mikhalych63/DAW-Pro4/DAW-Pro4/Enlosure/Bottom.png

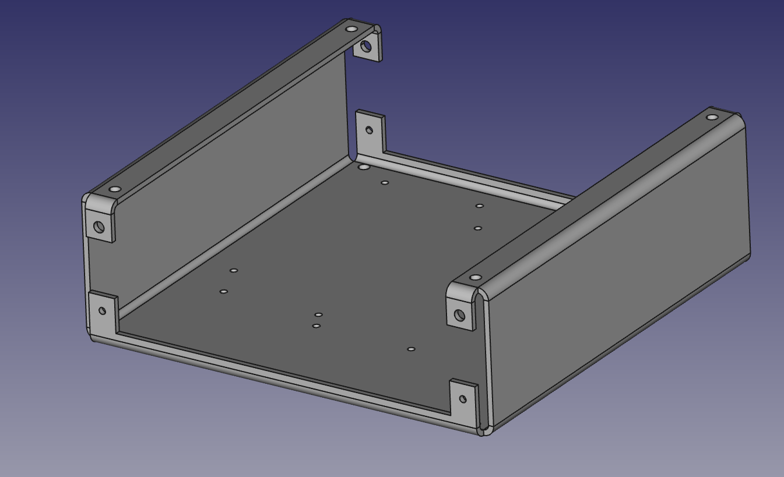
DAW-Pro4/Enlosure/Bottom.png
