mikhalych63/DAW-Pro4/README.md

This is a project of car audio processor and 8ch amplifier wich use of CamillaDSP project: https://github.com/HEnquist/camilladsp
