mikhalych63/DAW-Pro4/DAW-Pro4/Renderers/out/DAW03.pdf

# Digital Audio Ware V3.0

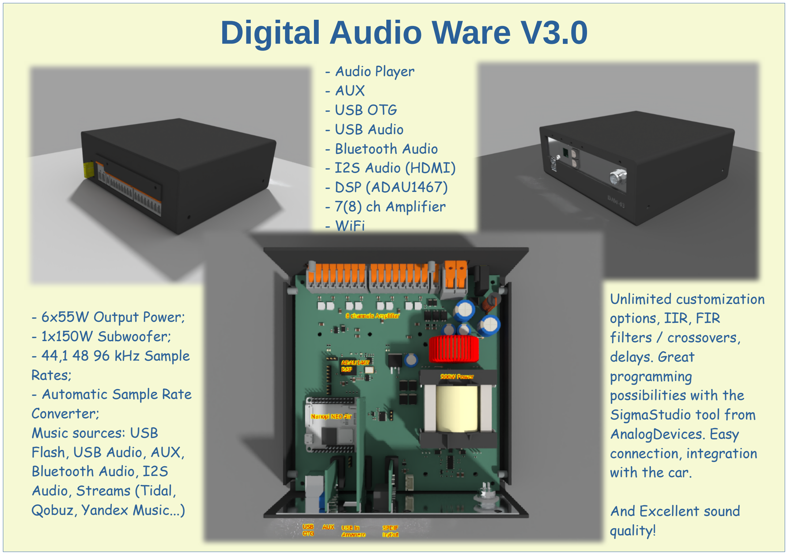
[picture p9: page 1]

- Audio Player
- AUX
- USB OTG
- USB Audio
- Bluetooth Audio
- I2S Audio (HDMI)
- DSP (ADAU1467)
- 7(8) ch Amplifier
- WiFi
- 6x55W Output Power;
- 1x150W Subwoofer;
- 44,1 48 96 kHz Sample
Rates;
- Automatic Sample Rate
Converter;
Music sources: USB
Flash, USB Audio, AUX,
Bluetooth Audio, I2S
Audio, Streams (Tidal,
Qobuz, Yandex Music...)

Unlimited customization
options, IIR, FIR
filters / crossovers,
delays. Great
programming
possibilities with the
SigmaStudio tool from
AnalogDevices. Easy
connection, integration
with the car.

And Excellent sound
quality!
