mikhalych63/DAW-Pro4/DAW-Pro4/Enlosure/enclosure-Bottom.pdf

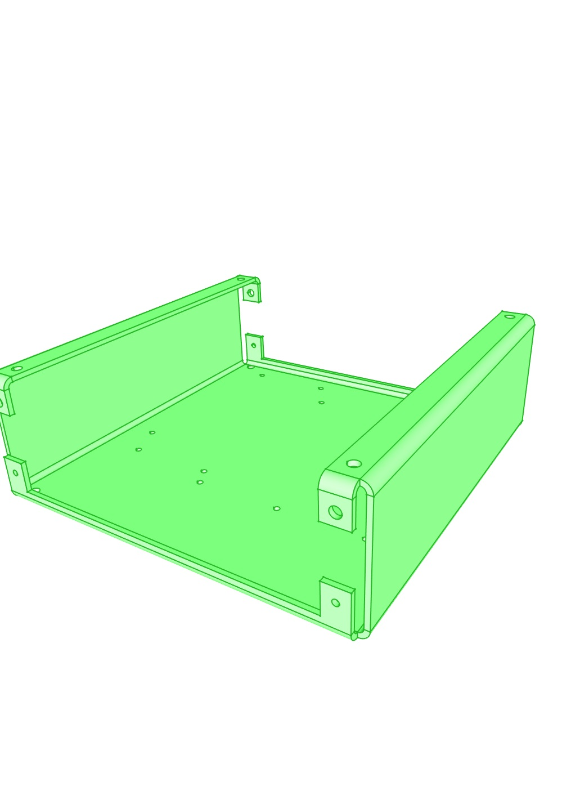
[picture p10: page 1]
