mikhalych63/DAW-Pro4/DAW-Pro4/Enlosure/enclosure-Front.pdf

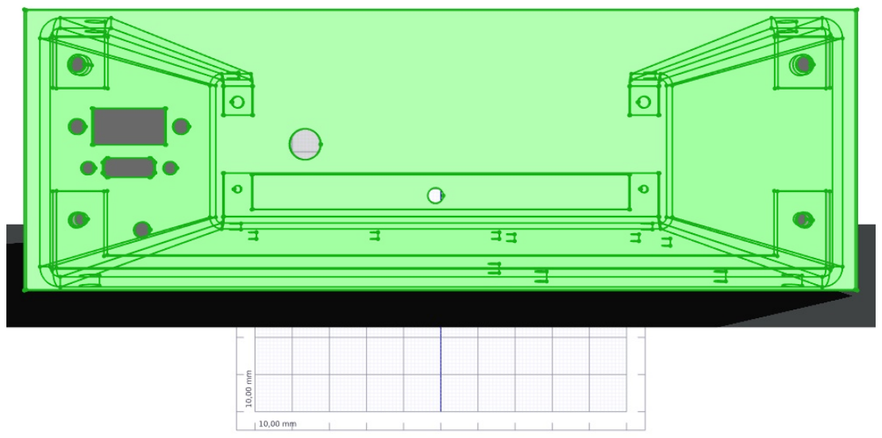
[picture p11: page 1]
