mikhalych63/DAW-Pro4/DAW-Pro4/Enlosure/Лицевая.pdf

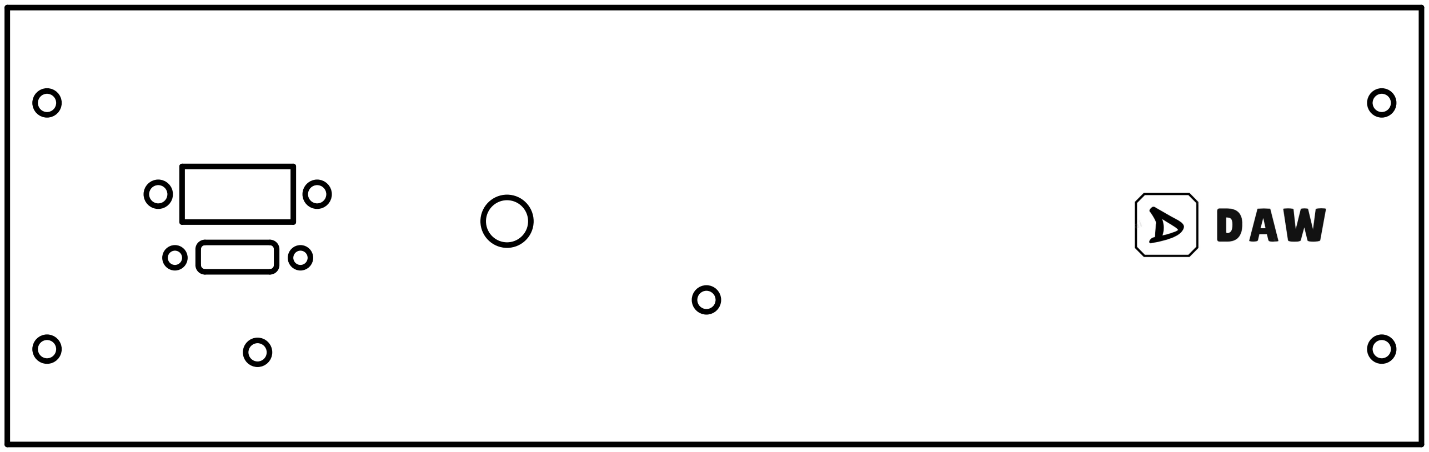
[picture p12: figure]
