mikhalych63/DAW-Pro4/DAW-Pro4/Renderers/0/DAW-Pro4.png

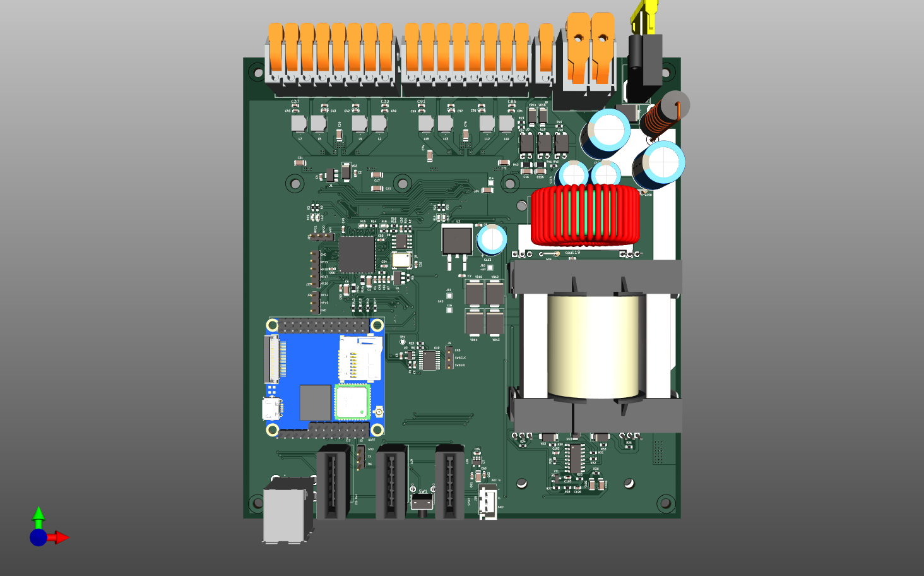
DAW-Pro4/Renderers/0/DAW-Pro4.png
