mikhalych63/DAW-Pro4/DAW-Pro4/Renderers/DAW-Pro4_0.png

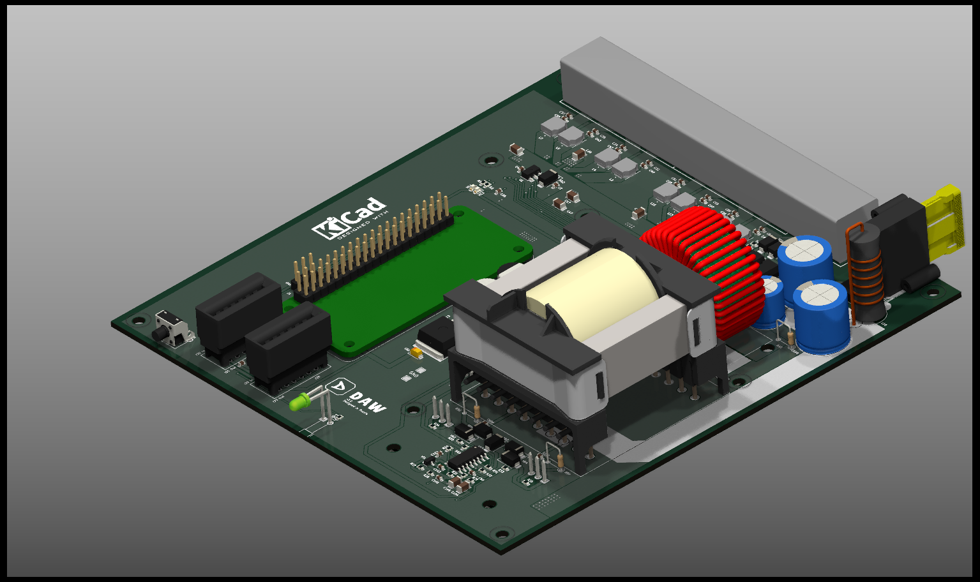
DAW-Pro4/Renderers/DAW-Pro4_0.png
