mikhalych63/DAW-Pro4/DAW-Pro4/Renderers/DAW-Pro4_1.png

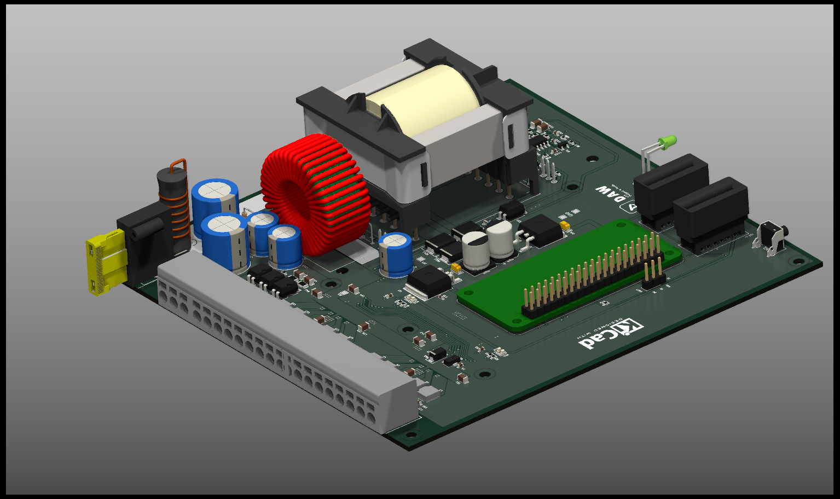
DAW-Pro4/Renderers/DAW-Pro4_1.png
