mikhalych63/DAW-Pro4/DAW-Pro4/Renderers/DAW-Pro4_2.png

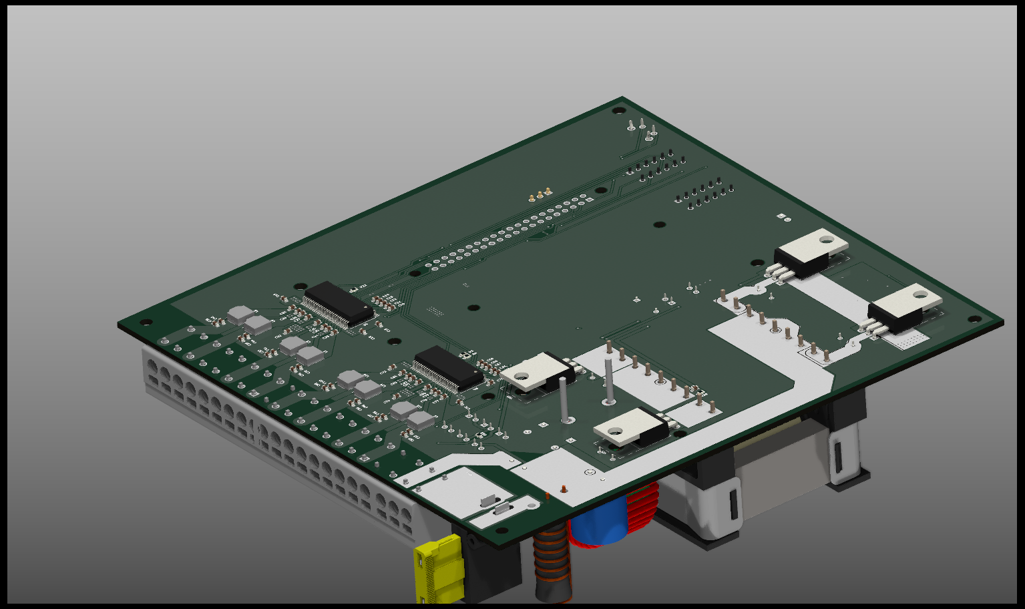
DAW-Pro4/Renderers/DAW-Pro4_2.png
