mikhalych63/DAW-Pro4/DAW-Pro4/Renderers/out/render-back.png

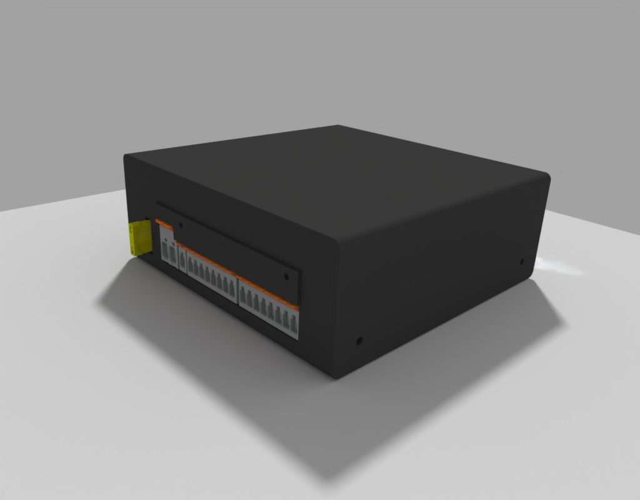
DAW-Pro4/Renderers/out/render-back.png
