mikhalych63/DAW-Pro4/DAW-Pro4/Renderers/out/render-front.png

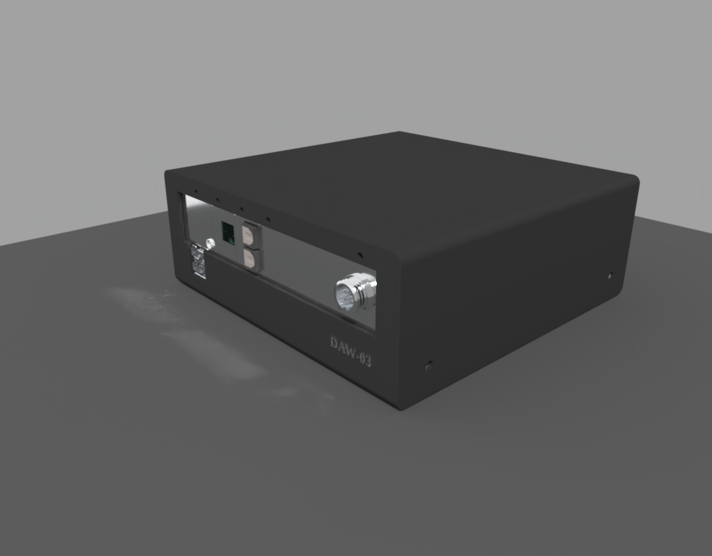
DAW-Pro4/Renderers/out/render-front.png
