mikhalych63/DAW-Pro4/DAW-Pro4/Renderers/out/render-top.png

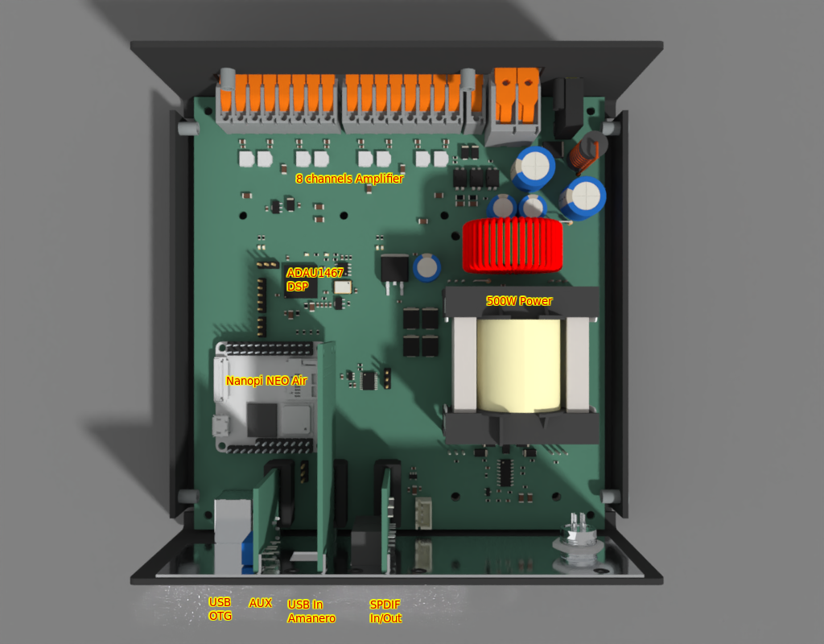
DAW-Pro4/Renderers/out/render-top.png
