mikhalych63/DAW-Pro4/DAW-Pro4/Renderers/render1-alu-cap.png

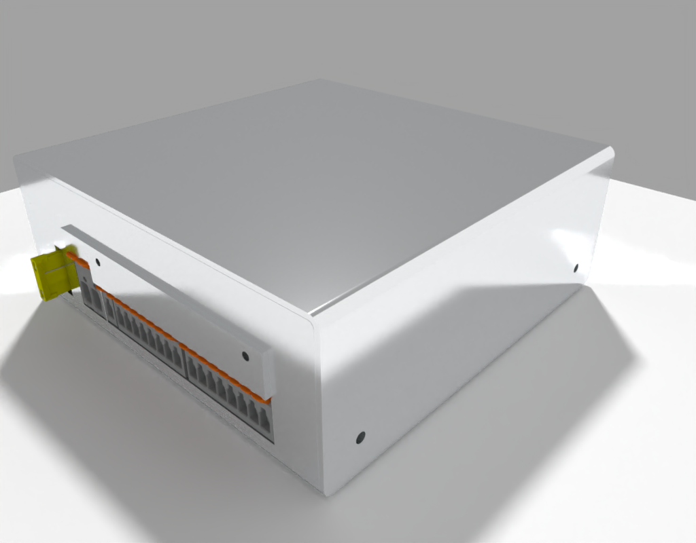
DAW-Pro4/Renderers/render1-alu-cap.png
