mikhalych63/DAW-Pro4/DAW-Pro4/Renderers/render1-black-cap.png

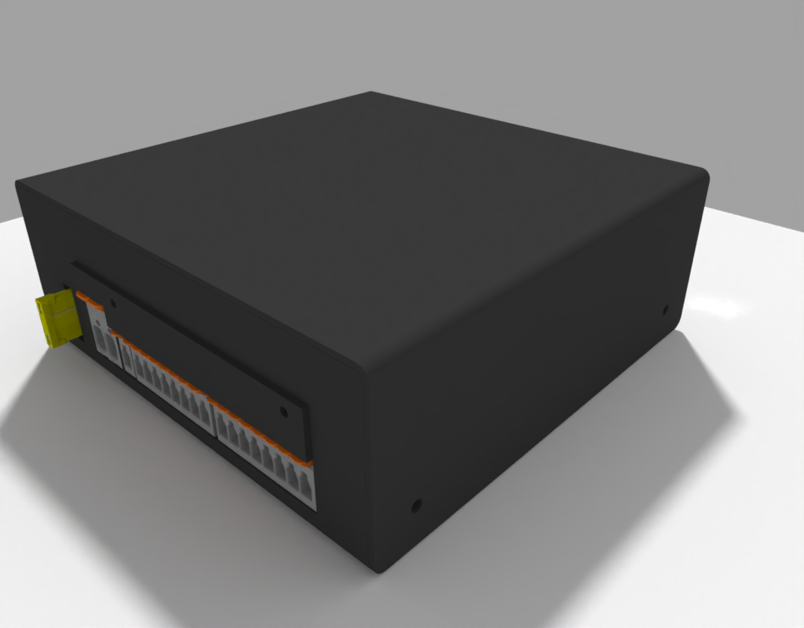
DAW-Pro4/Renderers/render1-black-cap.png
