mikhalych63/DAW-Pro4/DAW-Pro4/Renderers/render1-black.png

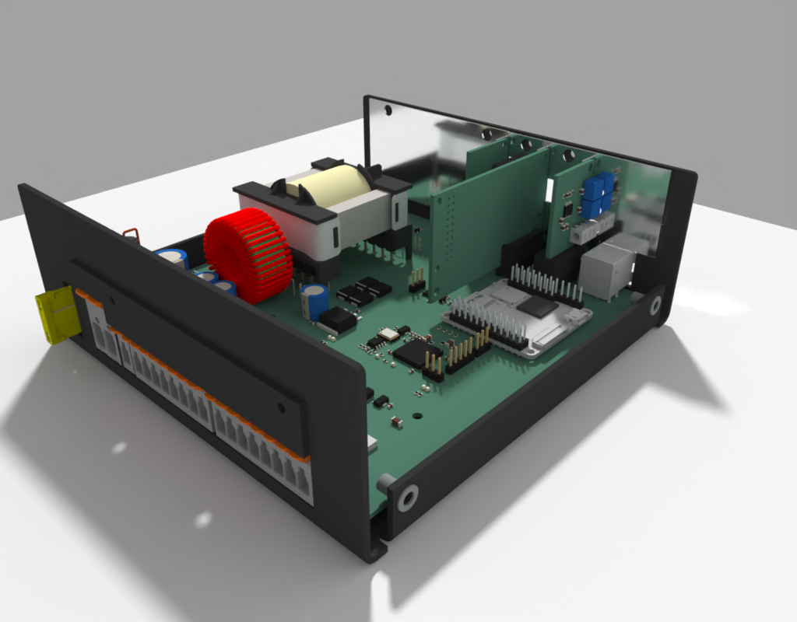
DAW-Pro4/Renderers/render1-black.png
