mikhalych63/DAW-Pro4/DAW-Pro4/Renderers/render2-alu.png

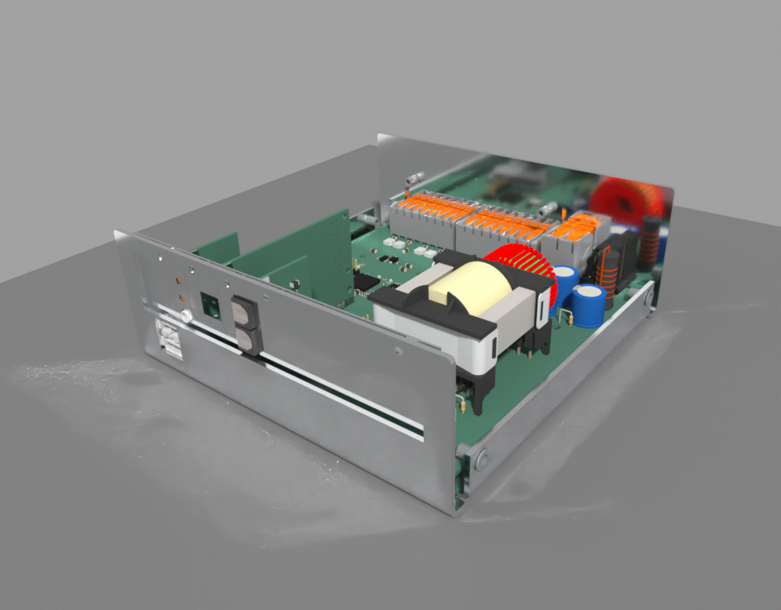
DAW-Pro4/Renderers/render2-alu.png
