mikhalych63/DAW-Pro4/DAW-Pro4/bom/bom_daw00.ods

Идентиф. | Обозначение | Посад.место | Количество | Значение | Поставщик и справка
1 | C104 | C_1206_3216Metric | 1 | CAP_2u2_50V_X7R_1206
2 | C106,C103,C94,C45,C40,C43,C96,C61,C49,C99,C97,C42,C95,C100,C44,C41,C93,C98,C46,C39 | C_0603_1608Metric | 20 | CAP_10n_50V_X7R_0603
3 | C107,C108 | CP_Radial_D14.0mm_P5.00mm | 2 | 2200μ
4 | C11,C68,C25,C81,C80,C65,C29,C66,C27,C26,C83,C69,C78,C84,C67,C77,C82,C10,C14,C79,C12,C24,C28,C23,C13,C30 | C_0603_1608Metric | 26 | CAP_1u0_25V_X7R_0603
5 | C110,C109 | C_0603_1608Metric | 2 | CAP_22n_50V_X7R_0603
6 | C111,C102 | C_0603_1608Metric | 2 | CAP_1n_50V_X7R_0603
7 | C112,C62,C53,C57,C8,C5,C60,C54,C56,C3,C55,C4,C50,C9,C72,C22,C15,C76,C73,C18,C70,C19 | C_0603_1608Metric | 22 | CAP_100n_50V_X7R_0603
8 | C115,C114,C113 | CP_Radial_D10.0mm_P5.00mm | 3 | 330μ
9 | C32,C91,C88,C34,C37,C86,C35,C89,C31,C36,C38,C90,C85,C92,C33,C87 | C_0805_2012Metric | 16 | CAP_1u0_50V_X7R_0805
10 | C48 | C_0603_1608Metric | 1 | CAP_150p_50V_C0G_0603
11 | C51 | C_0603_1608Metric | 1 | CAP_5n6_50V_X7R_0603
12 | C52 | C_0603_1608Metric | 1 | CAP_10n_25V_X7R_0603
13 | C63,C6,C1,C20,C17,C47,C64,C21,C75,C71,C105,C125,C74 | C_1206_3216Metric | 13 | CAP_10u0_50V_X7R_1206
14 | C7,C2 | C_0603_1608Metric | 2 | CAP_0u33_50V_X7R_0603
15 | F1 | Fuse_Blade_vertical | 1 | Fuse
16 | FER1,FER2 | R_0805_2012Metric_Pad1.20x1.40mm_HandSolder | 2 | BLM21AG102SN1D
17 | HL1,HL4 | LED_0603_1608Metric | 2 | LED_SMD_0603_YELLOW
18 | HL3,HL2 | LED_0603_1608Metric | 2 | LED_SMD_0603_RED
19 | HL6,HL5 | LED_0603_1608Metric_Pad1.05x0.95mm_HandSolder | 2 | LED_SMD_0603_BLUE
21 | J12,J20,J19 | Conn_edge_2x6_2.54_Male | 3 | Conn_01x06_Male
26 | J2 | USB_A_STACKED | 1 | USB_A_Stacked
28 | J22 | DEGSON_2x7.5 | 1 | KF206-7.5-2P
31 | J6,J18 | DEGSON_8x5 | 2 | DEGSON 2604 8x5
32 | J8 | DEGSON_1x5 | 1 | DEGSON 2604 1x5
33 | JP1 | R_0603_1608Metric_Pad0.98x0.95mm_HandSolder | 1 | CON_JUMPER
34 | L10,L15,L4,L2,L5,L12,L13,L7,L11,L3,L14,L16,L6,L9,L1,L8 | SPM5010-5020 | 16 | SPM5020T-3R3M-LR_TDK
35 | L18 | L_Axial_L26.0mm_D9.0mm_P5.08mm_Vertical | 1 | 5μ
36 | L19 | L_Axial_L26.0mm_D9.0mm_P5.08mm_Vertical | 1 | 25μ
37 | Q1 | SOT-89-3 | 1 | 2STF2360
38 | R14,R16 | R_0603_1608Metric | 2 | RES_51R0_1%_0.125W_Thick_0603
39 | R20,R3,R2,R21,R8 | R_0603_1608Metric | 5 | RES_1K0_1%_0.125W_Thick_0603
40 | R25 | R_0603_1608Metric | 1 | 15k
41 | R26 | R_0603_1608Metric | 1 | 150
42 | R27 | R_0603_1608Metric | 1 | 3k
43 | R28 | R_0603_1608Metric | 1 | 3,6k
44 | R30,R33,R29 | R_0603_1608Metric | 3 | 10
45 | R35,R34,R32,R31,R39 | R_0603_1608Metric | 5 | 1k
46 | R36,R37 | R_Axial_DIN0204_L3.6mm_D1.6mm_P5.08mm_Vertical | 2 | 4.7
47 | R38 | R_Axial_DIN0204_L3.6mm_D1.6mm_P5.08mm_Vertical | 1 | 100
48 | R4,R5,R22 | R_0603_1608Metric | 3 | RES_4K7_1%_0.125W_Thick_0603
49 | R40 | R_Axial_DIN0204_L3.6mm_D1.6mm_P5.08mm_Vertical | 1 | 1.5k
50 | R41 | R_0603_1608Metric | 1 | 1.2k
51 | R45 | R_0603_1608Metric | 1 | 330
52 | R7 | R_0603_1608Metric | 1 | RES_4K3_1%_0.125W_Thick_0603
53 | R9,R11,R10,R23,R12,R15,R1,R17,R6,R13 | R_0603_1608Metric | 10 | RES_10K0_1%_0.125W_Thick_0603
54 | TP1 | TestPoint_Pad_D1.5mm | 1 | Reset
55 | TR1 | Transformer_ETD44_Horizontal | 1 | TRANSF10
56 | U1 | SOT-89-3 | 1 | L78L18_SOT89
57 | U10 | TSSOP-20_4.4x6.5mm_P0.65mm | 1 | STM32F030F4Px
58 | U12 | Nanopi NEO | 1 | Nanopi NEO Air
59 | U13 | SOIC-16_3.9x9.9mm_P1.27mm | 1 | SG3525
60 | U16,U15 | DIP-4_W7.62mm | 2 | PC817
61 | U2 | TO-263-2 | 1 | LD1086D2T33TR
62 | U3 | SOT-23-5 | 1 | TPS3828-33DBVT
63 | U6 | LFCSP-88-1EP_10x10mm_P0.5mm_EP6.15x6.15mm | 1 | ADAU1467WBCPZ300RL
64 | U7 | SOT-23-5 | 1 | LP2985-5.0
65 | U8,U4 | SSOP-56_7.5x18.5mm_P0.635mm | 2 | TAS6424QDKQRQ1
66 | U9 | SOIC-8_3.9x4.9mm_P1.27mm | 1 | 25AA1024-I/SM
67 | VD1,VD12,VD13,VD11,VD10 | D_SMC | 5 | SS56
68 | VD15,VD4,VD3,VD5,VD14 | D_SMA | 5 | 1N5819
69 | VD2 | D_SMA | 1 | ES1D
70 | VD7,VD6 | D_SMA | 2 | 1N414E
71 | VD9,VD8 | TO-220-3_Horizontal_TabUp | 2 | MBR20100CT
72 | VT1 | SOT-23 | 1 | BC846
73 | VT2,VT3 | TO-220-3_Horizontal_TabUp | 2 | IRF3205
74 | X1 | Oscillator_SMD_SeikoEpson_SG8002CA-4Pin_7.0x5.0mm | 1 | SG-8002CA 24.5760M-PCBL3
