mikhalych63/DAW-Pro4/DAW-Pro4/bom/DAW-Pro4.xlsx

Идентиф. | Обозначение | Посад.место | Значение | Количество | Цена | Сумма | Поставщик и справка
1 | C104 | C_1206_3216Metric | CAP_2u2_50V_X7R_1206 | 1 | 15 | 15
2 | C107,C108 | CP_Radial_D14.0mm_P5.00mm | 2200μ | 2 | 120 | 240
3 | C109,C110 | C_0603_1608Metric | CAP_22n_50V_X7R_0603 | 2 | 2 | 4 | !
4 | C111,C102,C59 | C_0603_1608Metric | CAP_1n_50V_X7R_0603 | 3 | 2 | 6 | !
5 | C115,C114,C113 | CP_Radial_D10.0mm_P5.00mm | CAP_330μ_35V | 3 | 50 | 150
6 | C2 | C_0603_1608Metric | CAP_330n_50V_X7R_0603 | 1 | 2 | 2 | !
7 | C20,C17,C47,C64,C21,C75,C71,C105,C16,C125,C74 | C_1206_3216Metric | CAP_10u0_50V_X7R_1206 | 11 | 20 | 220
8 | C32,C91,C88,C34,C37,C86,C35,C89,C11,C68,C25,C31,C36,C81,C80,C65,C38,C29,C66,C27,C26,C83,C69,C78,C84,C67,C90,C85,C92,C33,C77,C82,C10,C14,C79,C12,C24,C28,C87,C23,C13,C30 | C_0603_1608Metric | CAP_1u_50V_X7R_0603 | 42 | 2 | 84
9 | C57,C54,C56,C55,C4,C72,C22,C15,C112,C76,C73,C18,C70,C19 | C_0603_1608Metric | CAP_100n_50V_X7R_0603 | 14 | 2 | 28 | !
10 | C60,C7 | CP_Elec_8x10 | 10u 16v | 2 | 20 | 40
11 | C8,C61 | CP_EIA-3216-18_Kemet-A | 10u 16v Tantalum | 2 | 25 | 50
12 | C94,C45,C40,C43,C96,C49,C103,C99,C97,C42,C106,C95,C100,C44,C41,C93,C98,C46,C39 | C_0603_1608Metric | CAP_10n_50V_X7R_0603 | 19 | 2 | 38
13 | D1 | D_DO-34_SOD68_P7.62mm_Horizontal | 1N4749A 24V | 1 | 17 | 17
14 | F1 | Fuse_Blade_vertical | Fuse | 1 | 40 | 40 | Ali
15 | HL1,HL4 | LED_0603_1608Metric | LED_SMD_0603_YELLOW | 2 | 18 | 36
16 | HL3,HL2 | LED_0603_1608Metric | LED_SMD_0603_RED | 2 | 18 | 36
17 | IC1 | RockPiS0 | Radxa Rock Pi S0 | 1 | 2500 | 2500 | Ali (заказал 2шт.)
18 | J1 | PinHeader_1x03_P2.54mm_Vertical | UART | 1 |  | 0
19 | J10 | TestPoint_Pad_1.5x1.5mm | +6V | 1 |  | 0
20 | J12,J20 | 2x6 | Conn_edge_2x6_2.54_Male | 2 | 100 | 200 | Ali
21 | J14 | TestPoint_Pad_1.5x1.5mm | +24V | 1 |  | 0
22 | J16,J11 | TestPoint_Pad_1.5x1.5mm | GND | 2 |  | 0
23 | J22 | DG271R-5.0-03P | DG271R-5.0-03P | 1 | 60 | 60
24 | J6,J18 | DG271R-5.0-08P | DG271R-5.0-08P | 2 | 217 | 434
25 | L10,L15,L4,L2,L5,L12,L13,L7,L11,L3,L14,L16,L6,L9,L1,L8 | SPM5020T-3R3M-LR | 3u3 | 16 | 35 | 560
26 | L18 | L_Axial_L26.0mm_D9.0mm_P5.08mm_Vertical | DMR30 5μ | 1 | 35 | 35 | ferrite.ru
27 | L19 | L_Toroid_Vertical_L33.0mm_W17.8mm_P12.70mm_Pulse_KM-5 | DT90-52 25μ | 1 | 25 | 25 | ferrite.ru
28 | R19 | R_0603_1608Metric | 10k | 1 | 2 | 2 | !
29 | R20,R3,R2,R21 | R_0603_1608Metric | 1K | 4 | 2 | 8 | !
30 | R24,R34,R31,R45,R32,R35,R39 | R_0603_1608Metric | 1k | 7 | 2 | 14 | !
31 | R25 | R_0603_1608Metric | 15k | 1 | 2 | 2 | !
32 | R26 | R_0603_1608Metric | 150 | 1 | 2 | 2 | !
33 | R27 | R_0603_1608Metric | 3k | 1 | 2 | 2 | !
34 | R28 | R_0603_1608Metric | 3,6k | 1 | 2 | 2 | !
35 | R33,R30,R29 | R_0603_1608Metric | 10 | 3 | 2 | 6 | !
36 | R36,R37 | R_Axial_DIN0204_L3.6mm_D1.6mm_P5.08mm_Vertical | 4.7 | 2 | 30 | 60
37 | R38 | R_Axial_DIN0204_L3.6mm_D1.6mm_P5.08mm_Vertical | 100 | 1 | 30 | 30
38 | R40 | R_Axial_DIN0204_L3.6mm_D1.6mm_P5.08mm_Vertical | 1.5k | 1 | 30 | 30
39 | R41,R42 | R_1206_3216Metric | 1.2k | 2 | 2 | 4
40 | R43,R18,R4,R5,R22 | R_0603_1608Metric | 4.7K | 5 | 2 | 10 | !
41 | R48 | R_0603_1608Metric | 1.5k | 1 | 2 | 2 | !
42 | R49,R50 | R_0603_1608Metric | 3.3K | 2 | 2 | 4 | !
43 | TR1 | Transformer_ETD44_Horizontal | TRANSF10 | 1 | 400 | 400 | ferrite.ru
44 | U1 | SOT-89-3 | L78L18_SOT89 | 1 | 25 | 25
45 | U11 | DIP-4_W7.62mm | PC817 | 1 | 20 | 20
46 | U13 | SOIC-16_3.9x9.9mm_P1.27mm | SG3525 | 1 | 200 | 200
47 | U16,U15,U5 | DIP-4_W7.62mm | TLP627 | 3 | 70 | 210
48 | U2 | TO-263-2 | LD1086D2T33TR | 1 | 110 | 110
49 | U7 | TO-263-2 | LD1086DT50TR | 1 | 110 | 110
50 | U8,U4 | SSOP-56_7.5x18.5mm_P0.635mm | TAS6424QDKQRQ1 | 2 | 220 | 440 | Ali
51 | VD1,VD12,VD13,VD11,VD10 | D_SMC | SS56 | 5 | 20 | 100
52 | VD15,VD4,VD3,VD5,VD14 | D_SMA | 1N5819 | 5 | 15 | 75
53 | VD2 | D_SMA | ES1D | 1 | 15 | 15
54 | VD7,VD6 | D_SMA | 1N4148 | 2 | 15 | 30
55 | VD9,VD8 | TO-220-3_Horizontal_TabUp | MBR20100CT | 2 | 65 | 130
56 | VT1 | SOT-23 | BC846 | 1 | 15 | 15
57 | VT2,VT3 | TO-220-3_Horizontal_TabUp | IRF3205 | 2 | 55 | 110
 |  |  |  |  |  | 6988
