mikhalych63/DAW-Pro4/DAW-Pro4/amanero/amanero.step

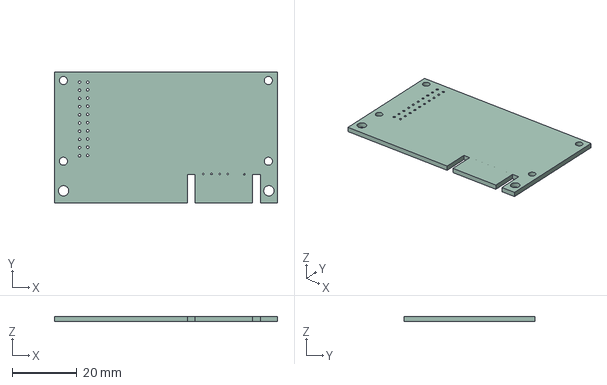
[picture p32: CAD file, 2024-10-08]
DAW-Pro4/amanero/amanero.step
69.1 x 40.6 x 1.60 mm
