mikhalych63/DAW-Pro4/DAW-Pro4/analog_input/analog_input.step

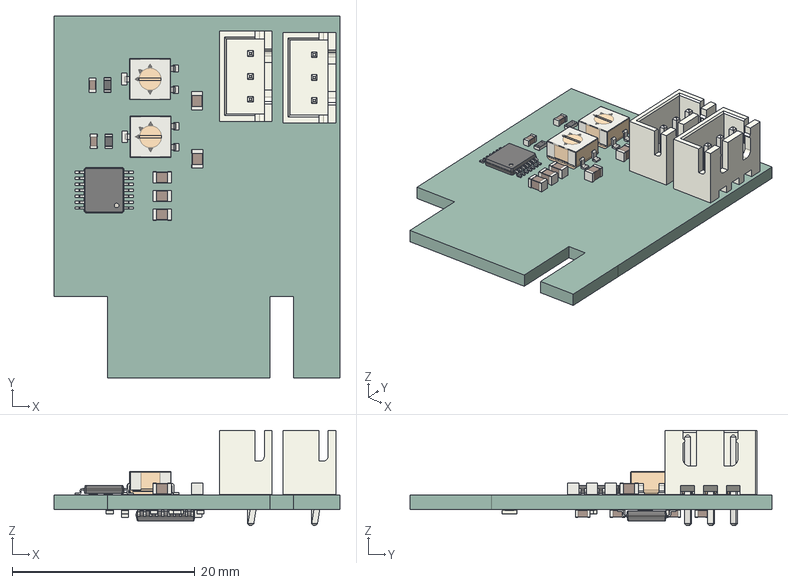
[picture p33: CAD file, 2024-10-08]
DAW-Pro4/analog_input/analog_input.step
31.2 x 39.6 x 10.4 mm
C_0805_2012Metric x 5
R_0603_1608Metric x 9
C_0603_1608Metric x 8
JST_B3B_XH_A x 2
TSSOP_14_44x5mm_P065mm
Potentiometer_Bourns_3314G_Vertical x 2
TSSOP_20_44x65mm_P065mm
analog_input_PCB
