mikhalych63/DAW-Pro4/DAW-Pro4/Enlosure/body.step

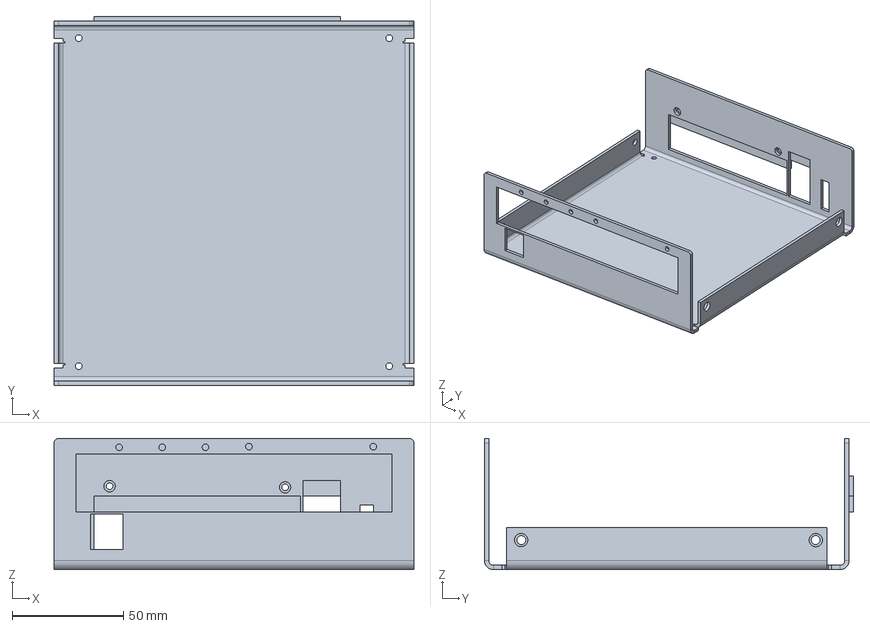
[picture p34: CAD file, 2024-10-08]
DAW-Pro4/Enlosure/body.step
162.0 x 166.1 x 59.0 mm
