mikhalych63/DAW-Pro4/DAW-Pro4/spdif/spdif.step

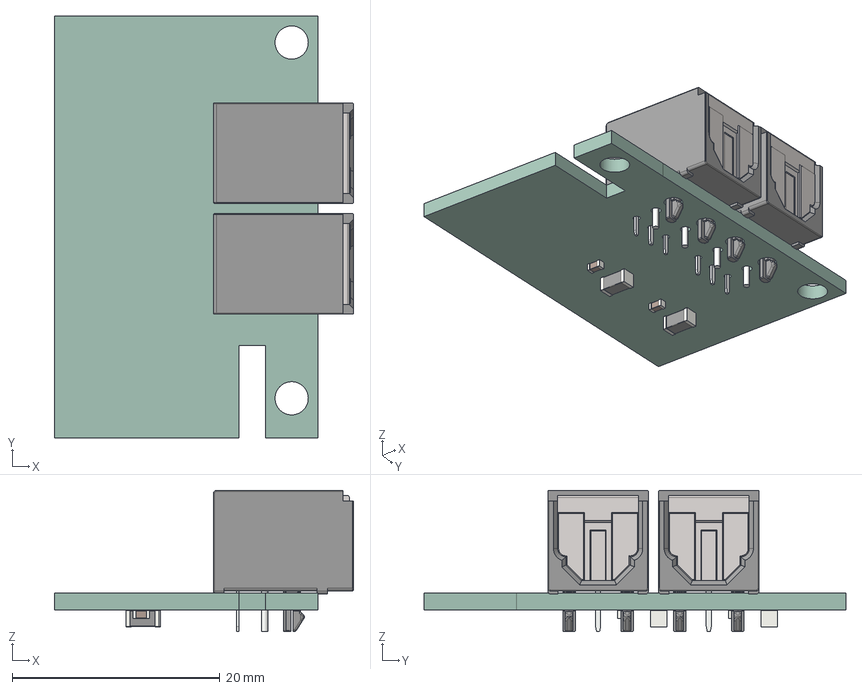
[picture p35: CAD file, 2024-10-08]
DAW-Pro4/spdif/spdif.step
28.8 x 40.6 x 13.6 mm
User Library-TORX147PL(f,t) x 2
L_1206_3216Metric x 2
C_0603_1608Metric x 2
spdif_PCB
