mikhalych63/DAW-Pro4/DAW-Pro4/Enlosure/cap.step

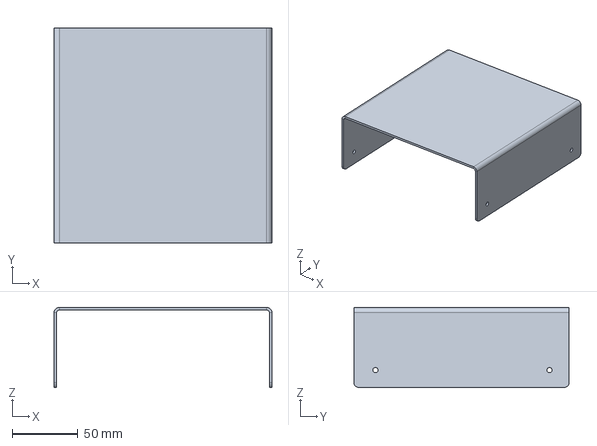
[picture p36: CAD file, 2024-10-08]
DAW-Pro4/Enlosure/cap.step
166.0 x 164.0 x 61.0 mm
