mikhalych63/DAW-Pro4/DAW-Pro4/Enlosure/daw00-analog_input 1.step

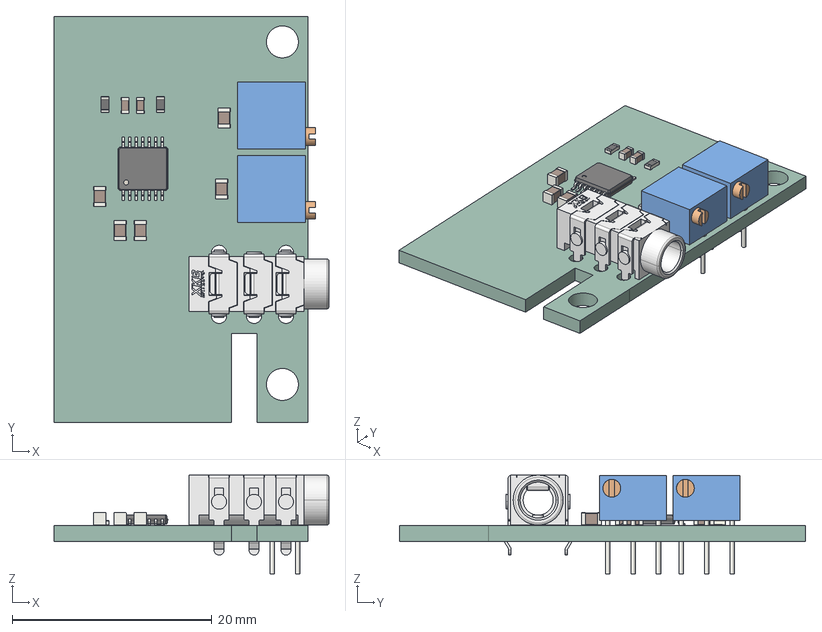
[picture p37: CAD file, 2024-10-08]
DAW-Pro4/Enlosure/daw00-analog_input 1.step
27.5 x 40.6 x 9.88 mm
C_0805_2012Metric032
C_0805_2012Metric034
R_0603_1608Metric078
R_0603_1608Metric080
C_0603_1608Metric154
C_0603_1608Metric156
TSSOP_14_44x5mm_P065mm
Potentiometer_Bourns_3266P_Horizontal
C_0805_2012Metric036
C_0805_2012Metric038
Potentiometer_Bourns_3266P_Horizontal002
C_0805_2012Metric040
PJ-3135-X
analog_input_PCB
