mikhalych63/DAW-Pro4/DAW-Pro4/Enlosure/Лицевая.dxf

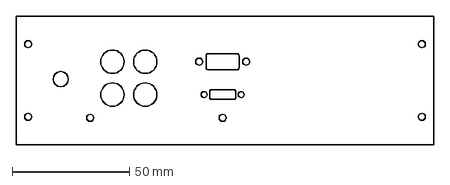
[picture p38: CAD file, 2024-10-08]
DAW-Pro4/Enlosure/Лицевая.dxf
178.0 x 55.0 mm
