mikhalych63/DAW-Pro4/DAW-Pro4/Enlosure/enclosure-Front.step

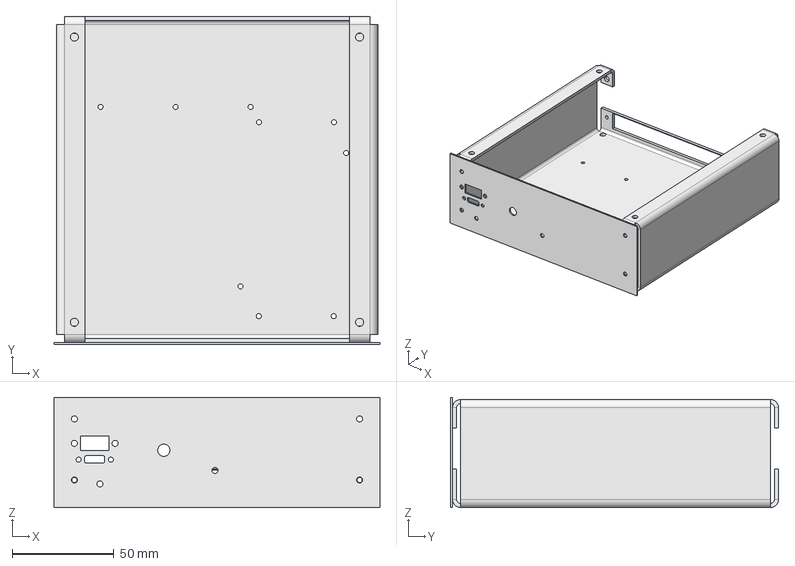
[picture p39: CAD file, 2024-10-08]
DAW-Pro4/Enlosure/enclosure-Front.step
160.0 x 161.0 x 54.0 mm
