mikhalych63/DAW-Pro4/DAW-Pro4/Enlosure/enclosure.FCStd

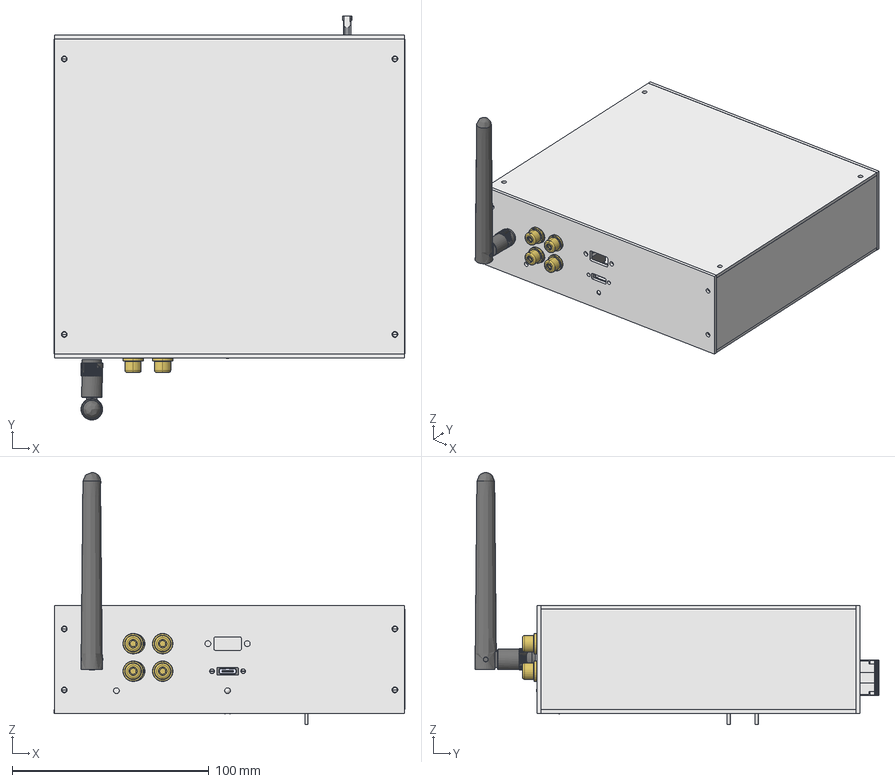
[picture p40: CAD file, 2024-10-08]
DAW-Pro4/Enlosure/enclosure.FCStd
178.3 x 205.3 x 128.1 mm
Bottom
R_0603_1608Metric x 38
Tube001
Tube
Нога2
Нога1
Куб
fuse_automotive_10a001
fuse_automotive_10a
C_0603_1608Metric x 89
C_1206_3216Metric x 12
CAD_SPM5020-LR x 16
DIP-4_W7.62mm x 4
D_SMC x 5
2300HT-100-V-RC
ETD 44
R_Axial_DIN0204_L36mm_D16mm_P508mm_Vertical x 4
LED_0603_1608Metric x 4
D_SMA x 8
CP_EIA_3216_18_Kemet_A x 2
CP_Radial_D100mm_P500mm x 3
R_1206_3216Metric x 2
L_Axial_L26.0mm_D9.0mm_P5.08mm_Vertical_Fastron_77A
CP_Elec_8x10 x 2
CQ assembly x 3
CP_Radial_D140mm_P500mm x 2
SOT_23
SOIC_16_39x99mm_P127mm
SW_Tactile_SPST_Angled_PTS645Vx58-2LFS
D_DO-34_SOD68_P7.62mm_Horizontal
PinHeader_1x03_P254mm_Vertical
LED_D3.0mm_Horizontal_O6.35mm_Z10.0mm
SSOP_56_75x185mm_P0635mm x 2
TO-220-3_Horizontal_TabUp x 4
DAW-Pro4_PCB
Front
Back
Right
Left
Top
TYPE-C-14-vertical_H-10mm1^TYPE-C-14-vertical_H-10mm(2)_TYPE-C-14-vertical_H-10mm
TYPE-C-14-vertical_H-10mm2^TYPE-C-14-vertical_H-10mm(2)_TYPE-C-14-vertical_H-10mm
TYPE-C-14-vertical_H-10mm3^TYPE-C-14-vertical_H-10mm(2)_TYPE-C-14-vertical_H-10mm
USB C female wall
USB C female PCB
ant
conn_body
SMA_threads
socket
RCA
RCA001
RCA002
RCA003
C_0805_2012Metric x 5
JST_B3B_XH_A x 2
TSSOP_14_44x5mm_P065mm
Potentiometer_Bourns_3314G_Vertical x 2
TSSOP_20_44x65mm_P065mm
analog_input_PCB
