mikhalych63/DAW-Pro4/DAW-Pro4/Enlosure/enclosure-Bottom.step

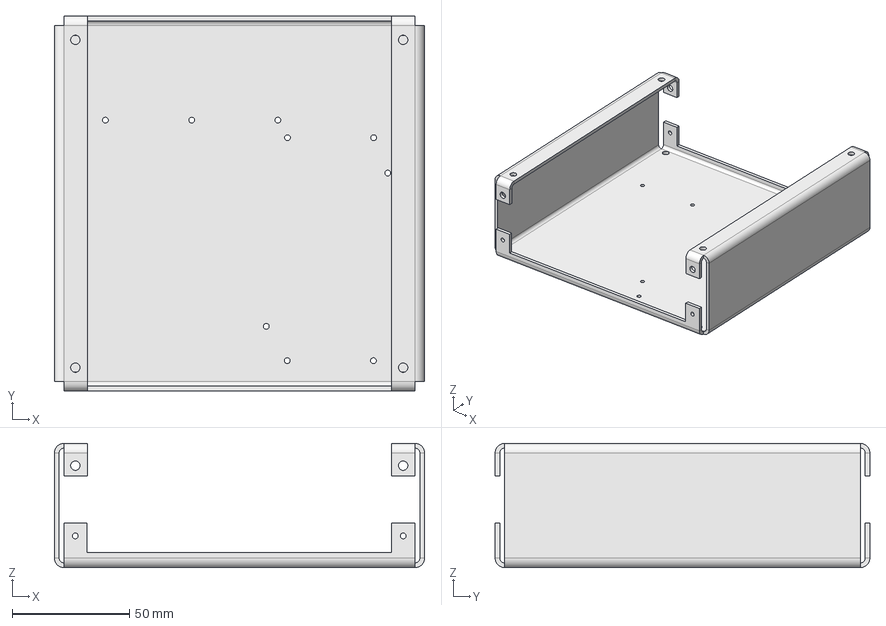
[picture p41: CAD file, 2024-10-08]
DAW-Pro4/Enlosure/enclosure-Bottom.step
158.0 x 160.0 x 53.0 mm
