mikhalych63/DAW-Pro4/DAW-Pro4/Enlosure/Чертеж.dxf

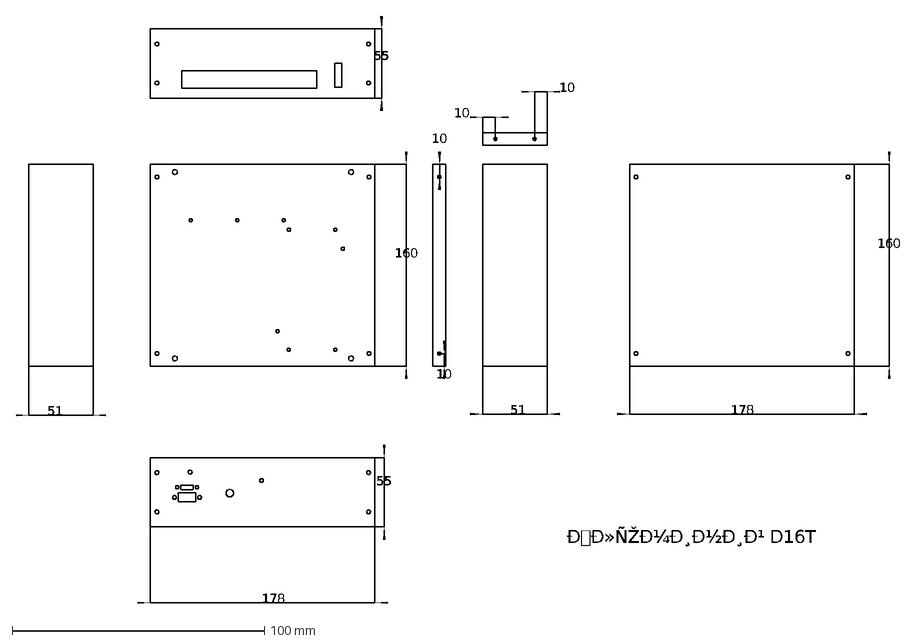
[picture p42: CAD file, 2024-10-08]
DAW-Pro4/Enlosure/Чертеж.dxf
160
51
55
178
10
