mikhalych63/DAW-Pro4/(list of files, cad)

Other CAD files:
DAW-Pro4/1.FCStd
DAW-Pro4/Enlosure/body.FCStd
DAW-Pro4/Enlosure/body.SLDPRT
DAW-Pro4/Enlosure/cap.FCStd
DAW-Pro4/Enlosure/cap.SLDPRT
DAW-Pro4/Enlosure/enclosure-Front.dxf
DAW-Pro4/analog_input/analog-input.FCStd
