mikhalych63/DAW-Pro4/DAW-Pro4/Enlosure/Чертеж.pdf

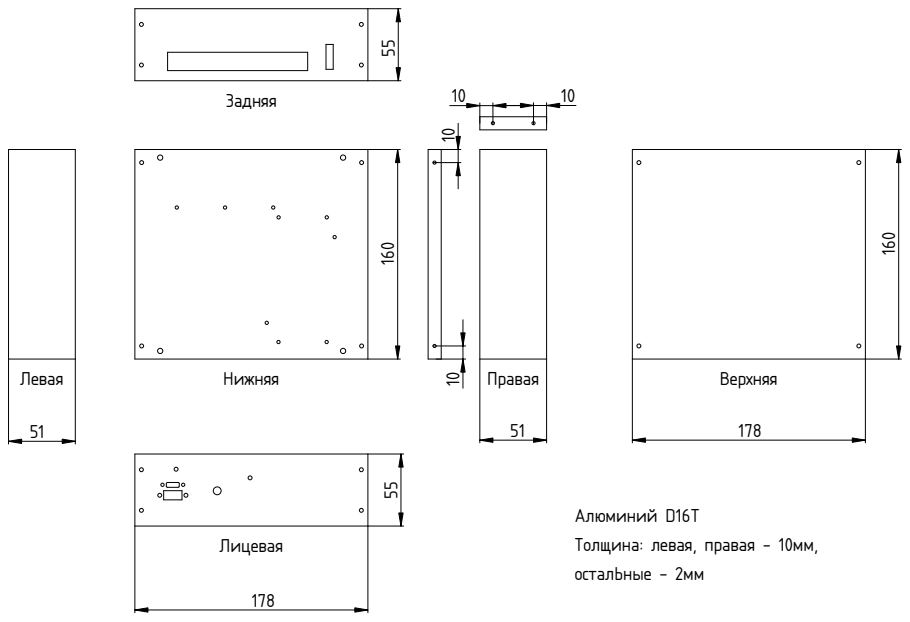
[picture p43: page 1]
Нижняя; Правая; Левая; Задняя; Лицевая; Верхняя

Алюминий D16T
Толщина: левая, правая - 10мм,
остальные - 2мм
