mikhalych63/DAW-Pro4/DAW-Pro4/DAW-Pro4.kicad_pcb

## KiCad design DAW-Pro4/DAW-Pro4.kicad_pcb (2024-10-08)

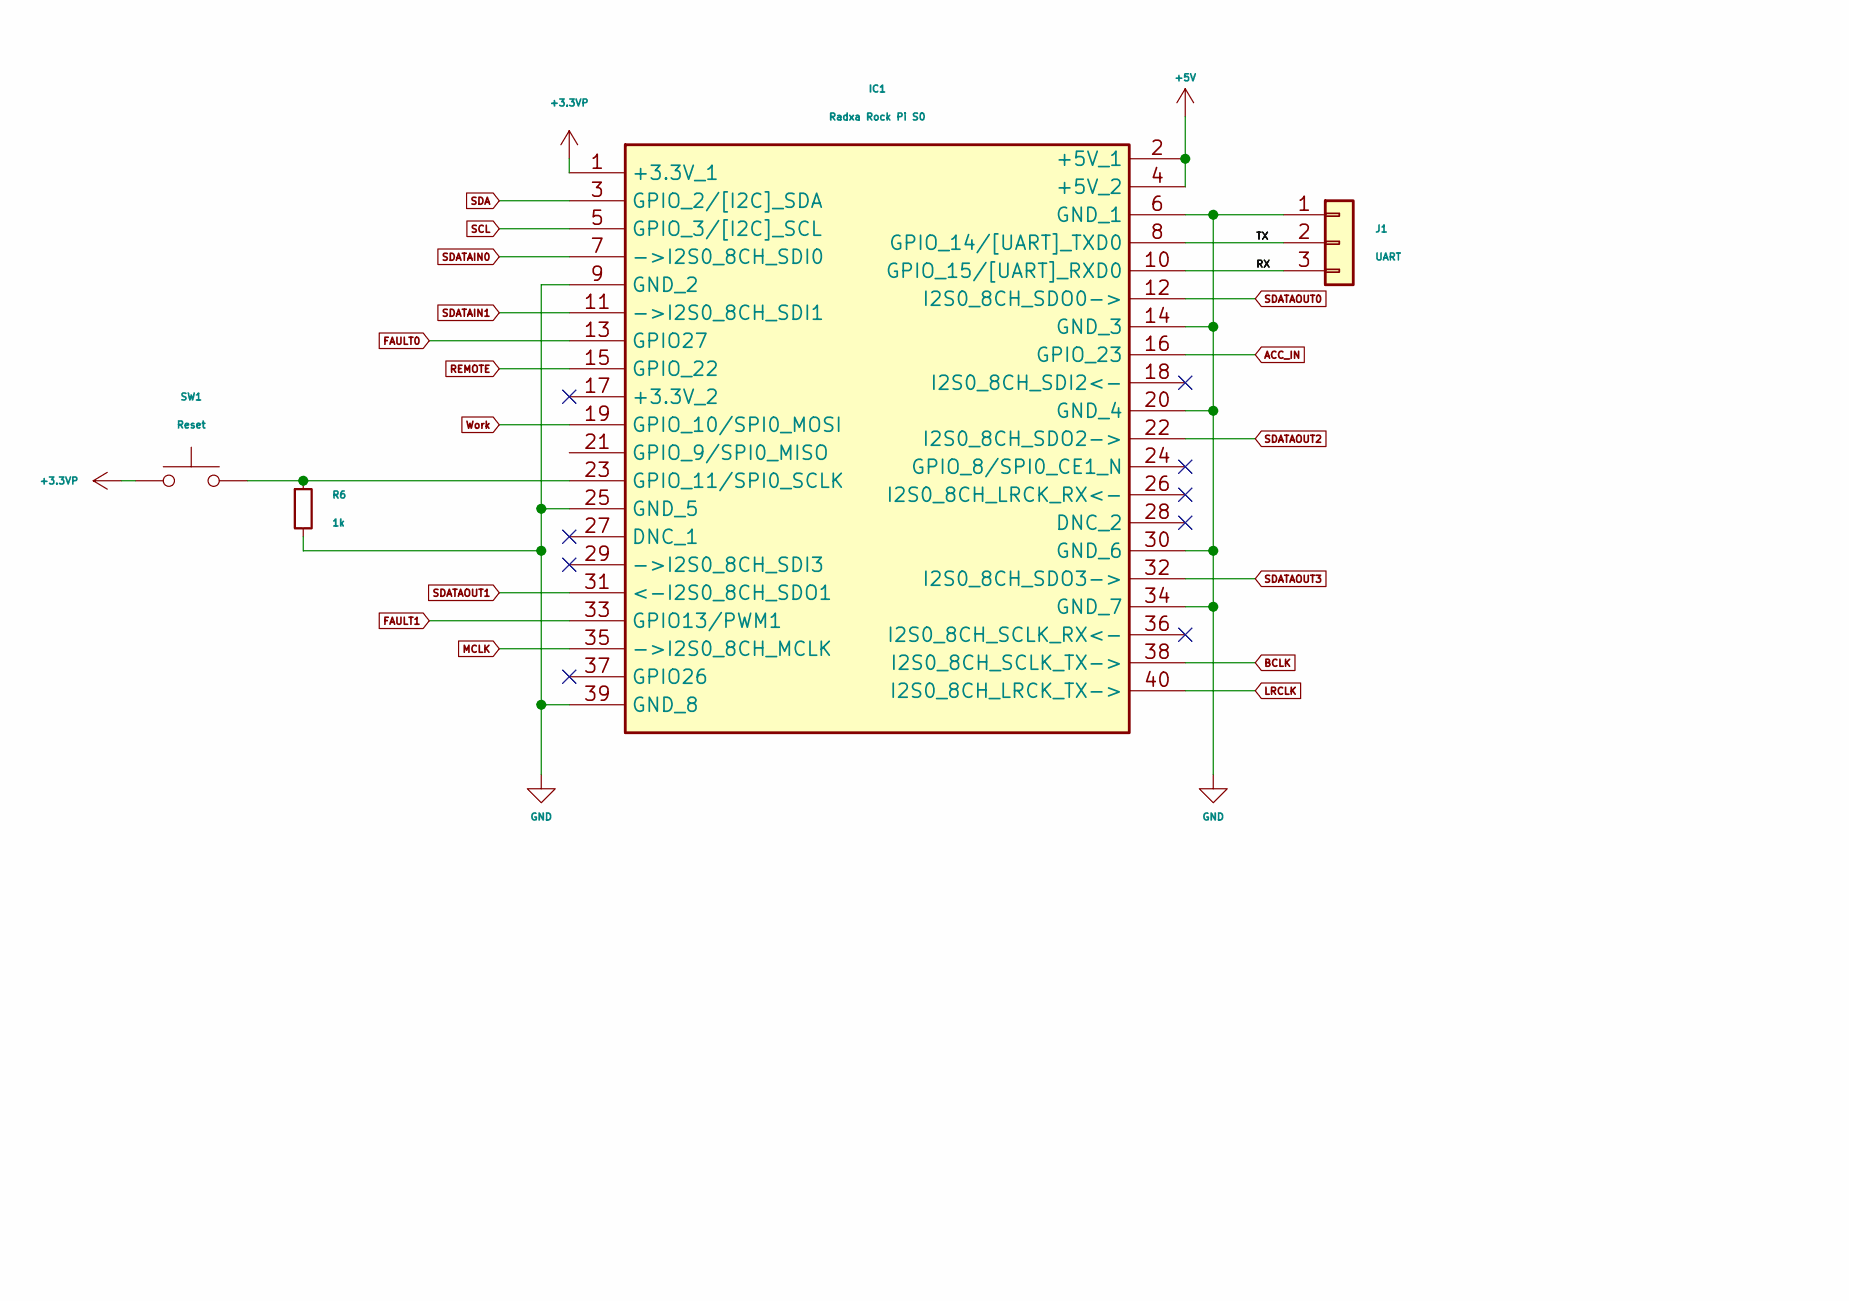
[picture p44: schematic Amplifier.kicad_sch, part in row 1, column 1]

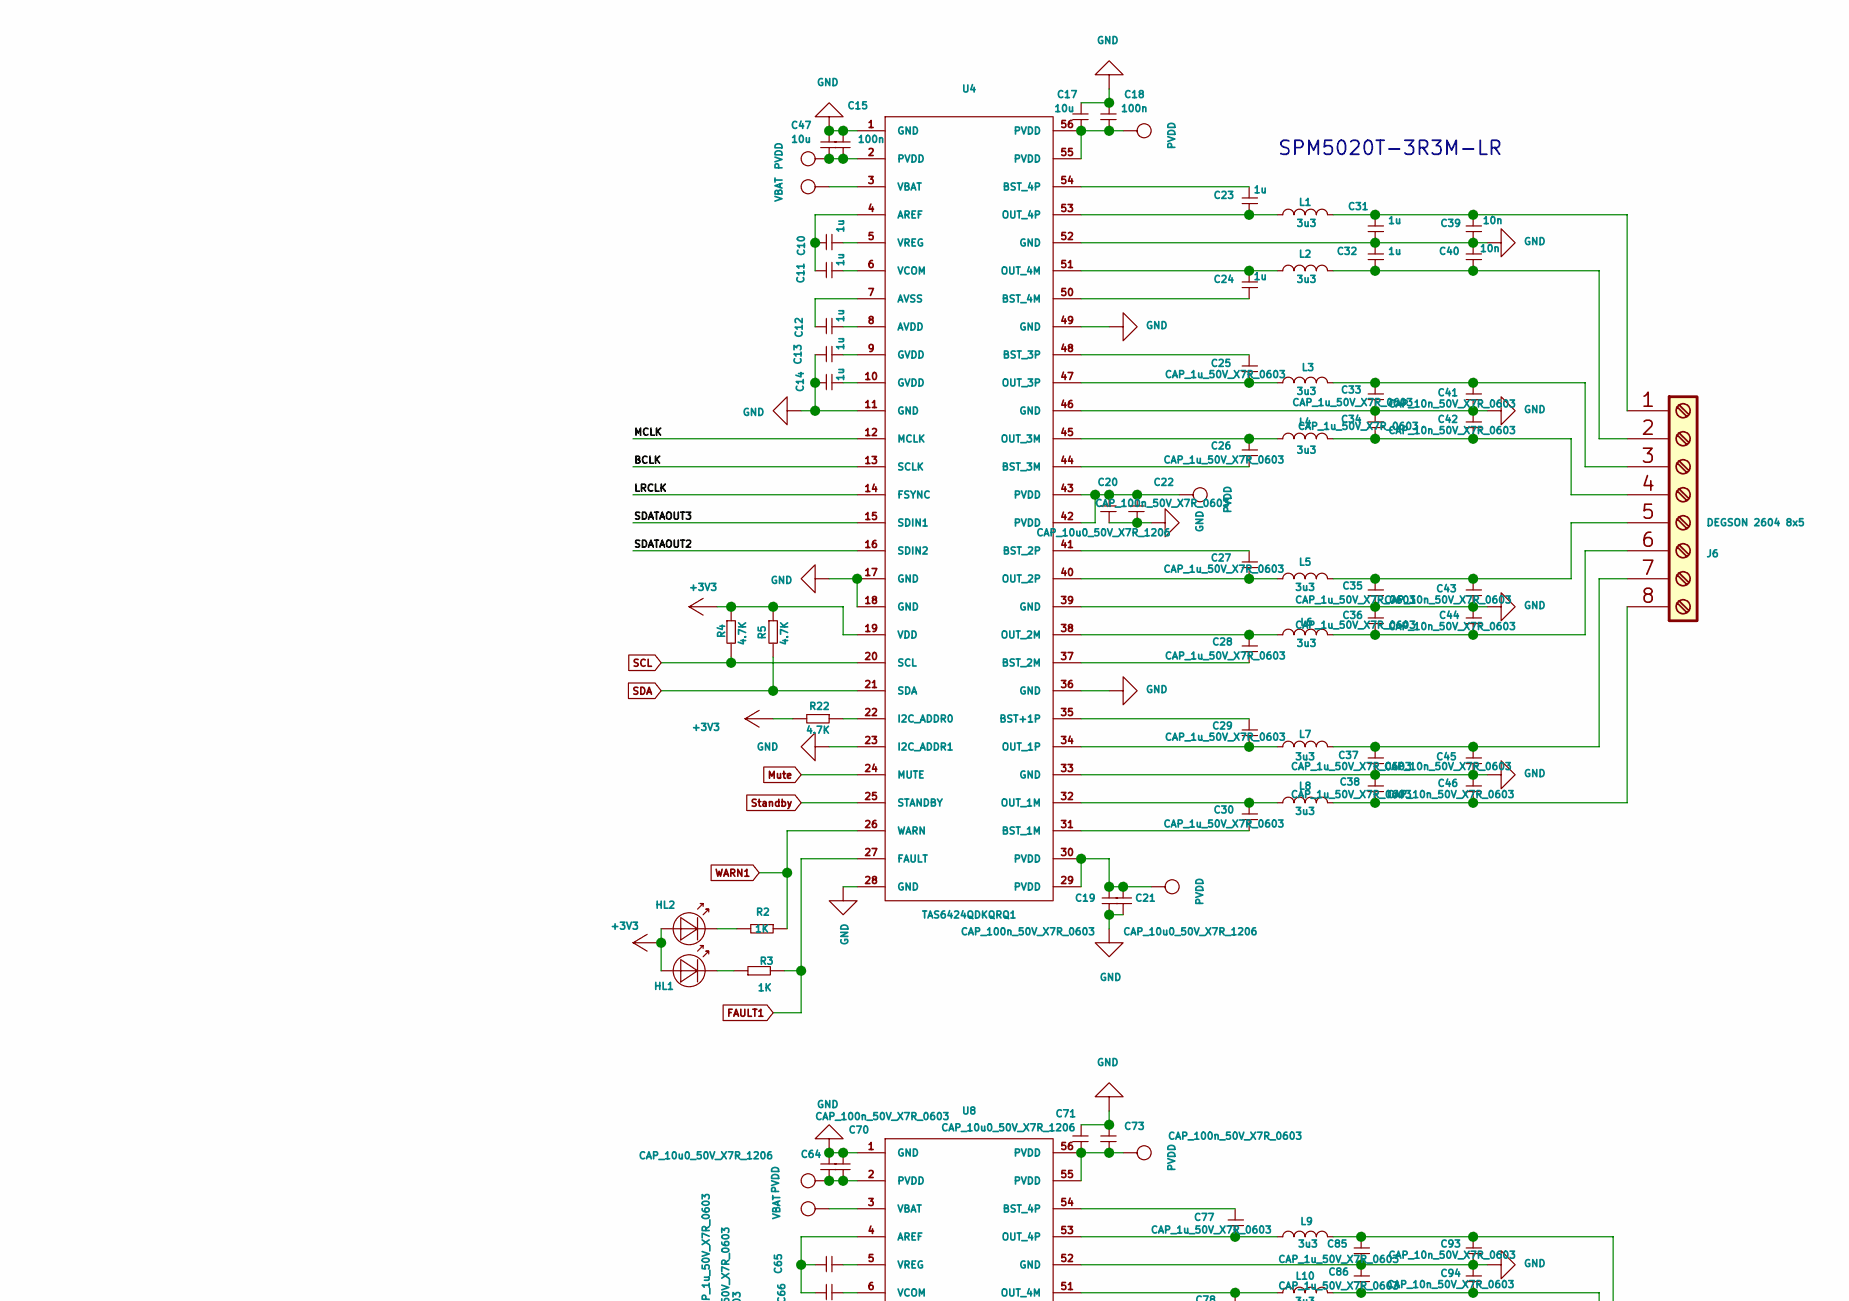
[picture p45: schematic Amplifier.kicad_sch, part in row 1, column 2]

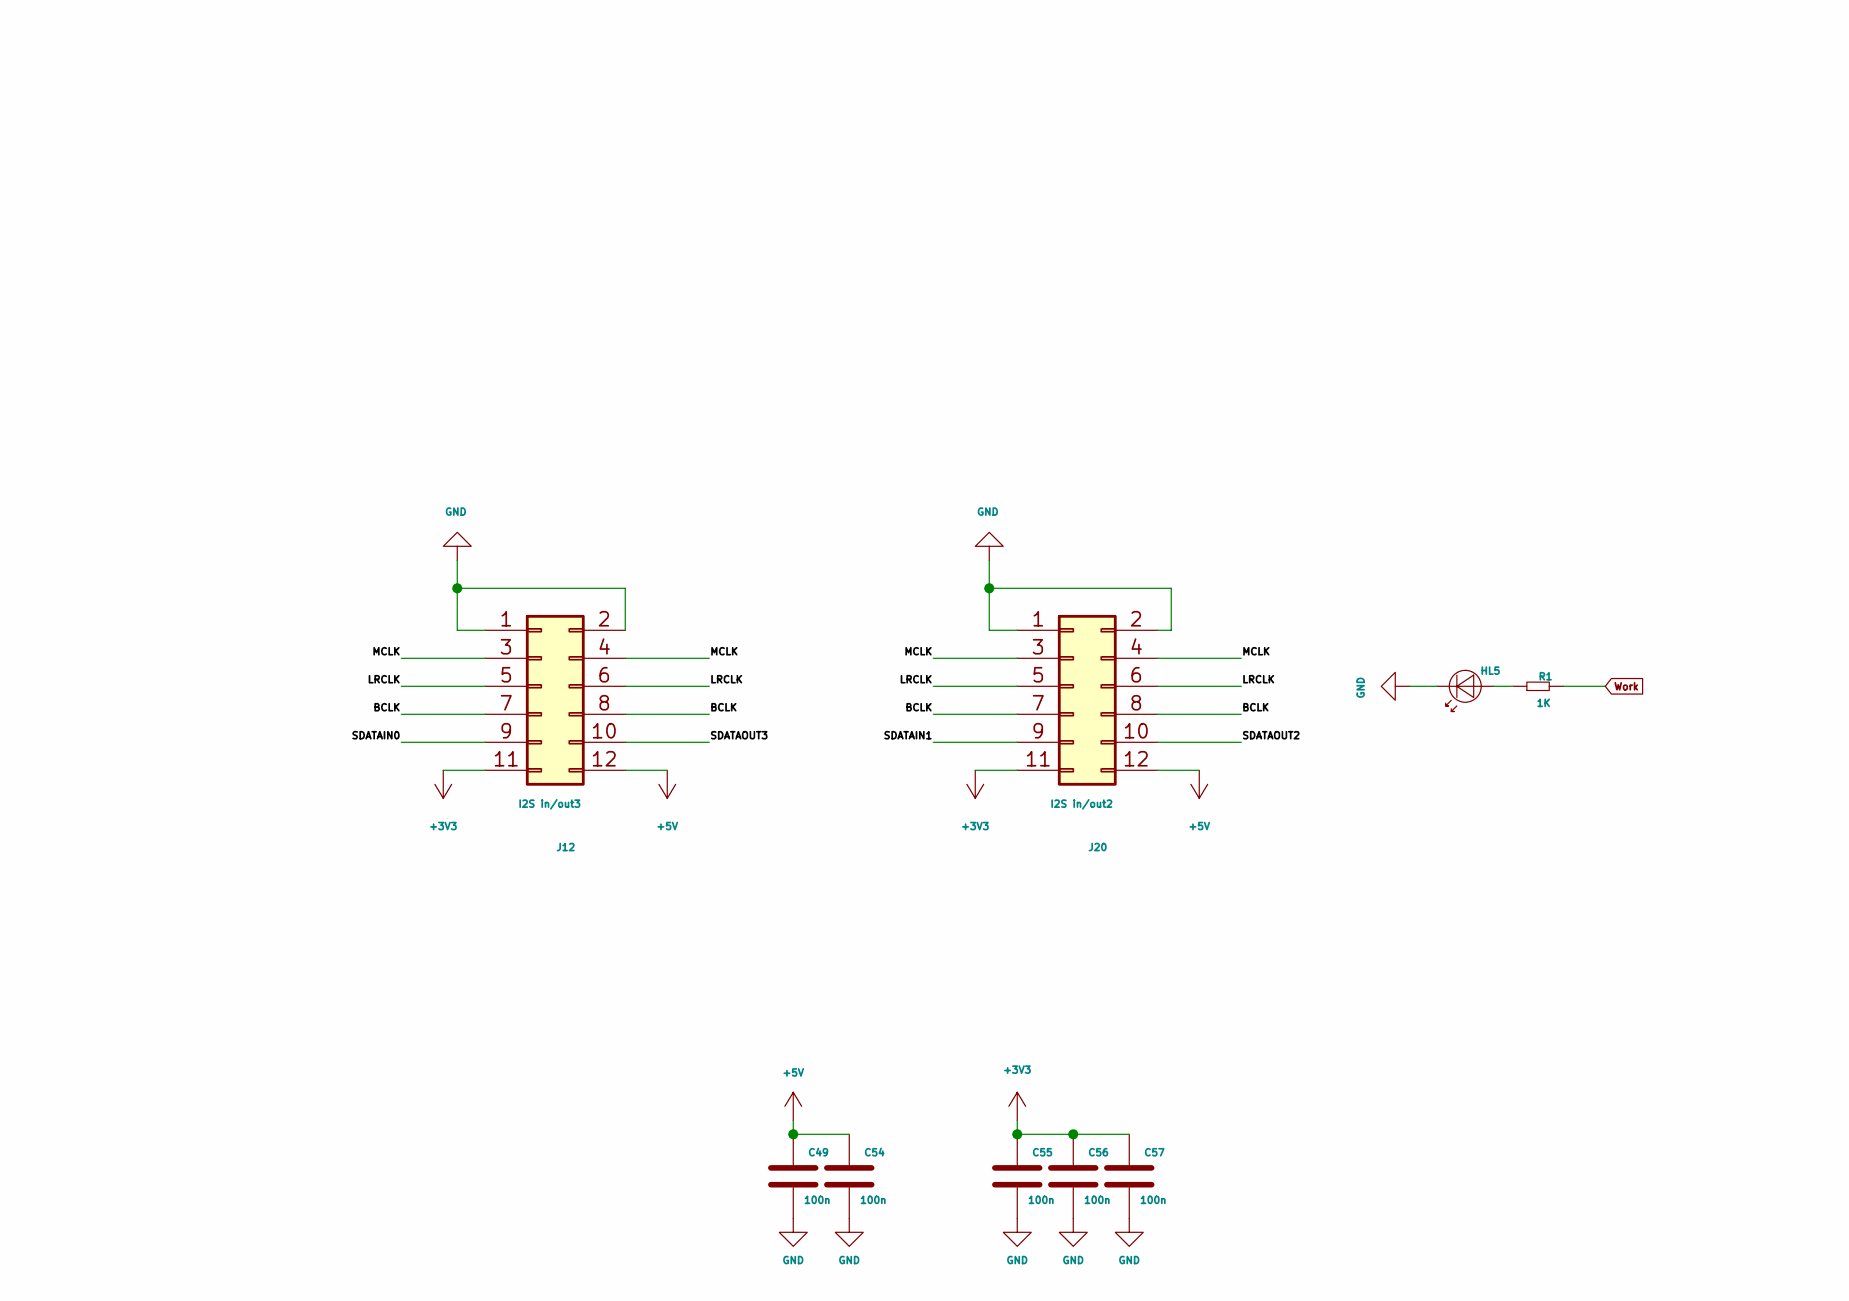
[picture p46: schematic Amplifier.kicad_sch, part in row 2, column 1]

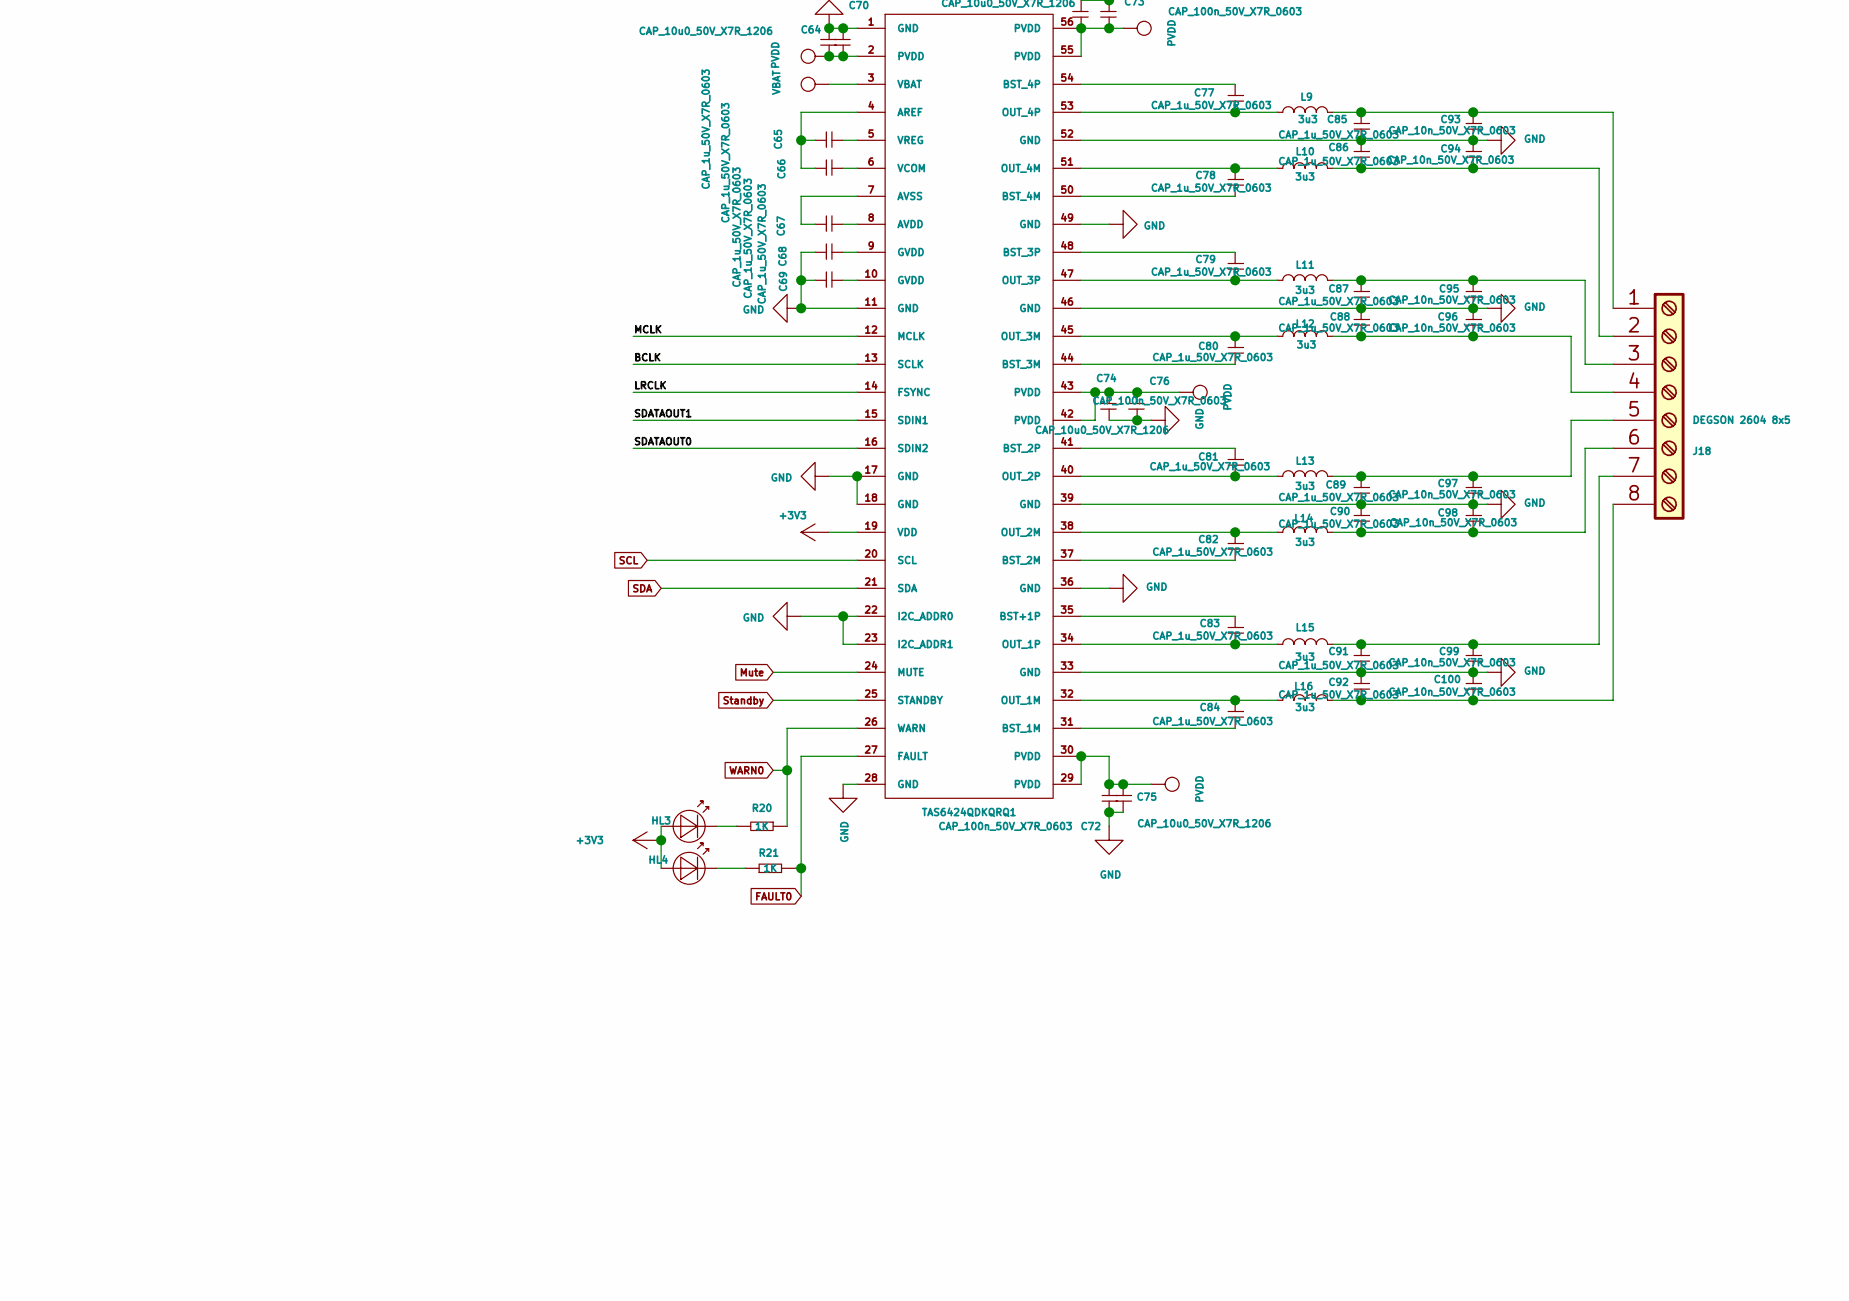
[picture p47: schematic Amplifier.kicad_sch, part in row 2, column 2]

Parts:
C10, C11, C12, C13, C14, C23, C24, C25, C26, C27, C28, C29, C30, C31, C32, C33, C34, C35, C36, C37, C38, C65, C66, C67, C68, C69, C77, C78, C79, C80, C81, C82, C83, C84, C85, C86, C87, C88, C89, C90, C91, C92: CAP_1u_50V_X7R_0603; C_0603_1608Metric
C15, C18, C19, C22, C70, C72, C73, C76: CAP_100n_50V_X7R_0603; C_0603_1608Metric
C17, C20, C21, C47, C64, C71, C74, C75: CAP_10u0_50V_X7R_1206; C_1206_3216Metric
C39, C40, C41, C42, C43, C44, C45, C46, C93, C94, C95, C96, C97, C98, C99, C100: CAP_10n_50V_X7R_0603; C_0603_1608Metric
C49: CAP_10n_50V_X7R_0603; C_0603_1608Metric; digikey 399-1170-1-ND
C54, C55, C56, C57: CAP_100n_50V_X7R_0603; C_0603_1608Metric; digikey 399-1170-1-ND
HL1, HL4: LED_SMD_0603_YELLOW; LED_0603_1608Metric
HL2, HL3: LED_SMD_0603_RED; LED_0603_1608Metric
HL5: LED_SMD_0603_YELLOW; LED_D3.0mm_Horizontal_O6.35mm_Z10.0mm
IC1: Radxa Rock Pi S0; RockPiS0; Manufacturer_Part_Number Raspberry Pi Zero W (v1.3)
J1: UART; PinHeader_1x03_P2.54mm_Vertical
J6, J18: DEGSON 2604 8x5; DG271R-5.0-08P
J12, J20: Conn_edge_2x6_2.54_Male; 2x6
L1, L2, L3, L4, L5, L6, L7, L8, L9, L10, L11, L12, L13, L14, L15, L16: 3u3; SPM5010-5020
R1, R2, R3, R20, R21: 1K; R_0603_1608Metric
R4, R5, R22: 4.7K; R_0603_1608Metric
R6: 1k; R_0603_1608Metric
SW1: Reset; SW_Tactile_SPST_Angled_PTS645Vx58-2LFS
U4, U8: TAS6424QDKQRQ1; SSOP-56_7.5x18.5mm_P0.635mm

Connections:
+3.3VP: IC1.1 (+3.3V_1), SW1.1; also elsewhere on the board
+3V3: C55.1, C56.1, C57.1, HL1.2 (A), HL2.2 (A), HL3.2 (A), HL4.2 (A), J12.11, J20.11, R4.1, R5.1, R22.2, U4.19 (VDD), U8.19 (VDD); also elsewhere on the board
+5V: C49.1, C54.1, IC1.2 (+5V_1), IC1.4 (+5V_2), J12.12, J20.12; also elsewhere on the board
/Amplifier/RX: IC1.10 (GPIO_15/[UART]_RXD0), J1.3
/Amplifier/TX: IC1.8 (GPIO_14/[UART]_TXD0), J1.2
ACC_IN: IC1.16 (GPIO_23); also elsewhere on the board
BCLK: IC1.38 (I2S0_8CH_SCLK_TX->), J12.7, J12.8, J20.7, J20.8, U4.13 (SCLK), U8.13 (SCLK)
FAULT0: IC1.13 (GPIO27), R21.2, U8.27 (FAULT)
FAULT1: IC1.33 (GPIO13/PWM1), R3.2, U4.27 (FAULT)
GND: C13.2, C14.2, C15.1, C17.1, C18.1, C19.1, C20.2, C21.1, C22.2, C31.1, C32.2, C33.1, C34.2, C35.1, C36.2, C37.1, C38.2, C39.1, C40.2, C41.1, C42.2, C43.1, C44.2, C45.1, C46.2, C47.1, C49.2, C54.2, C55.2, C56.2, C57.2, C64.1, C68.2, C69.2, C70.1, C71.1, C72.1, C73.1, C74.2, C75.1, C76.2, C85.1, C86.2, C87.1, C88.2, C89.1, C90.2, C91.1, C92.2, C93.1, C94.2, C95.1, C96.2, C97.1, C98.2, C99.1, C100.2, HL5.1 (K), IC1.6 (GND_1), IC1.9 (GND_2), IC1.14 (GND_3), IC1.20 (GND_4), IC1.25 (GND_5), IC1.30 (GND_6), IC1.34 (GND_7), IC1.39 (GND_8), J1.1, J12.1, J12.2, J20.1, J20.2, R6.2, U4.1 (GND), U4.11 (GND), U4.17 (GND), U4.18 (GND), U4.23 (I2C_ADDR1), U4.28 (GND), U4.33 (GND), U4.36 (GND), U4.39 (GND), U4.46 (GND), U4.49 (GND), U4.52 (GND), U8.1 (GND), U8.11 (GND), U8.17 (GND), U8.18 (GND), U8.22 (I2C_ADDR0), U8.23 (I2C_ADDR1), U8.28 (GND), U8.33 (GND), U8.36 (GND), U8.39 (GND), U8.46 (GND), U8.49 (GND), U8.52 (GND); also elsewhere on the board
LRCLK: IC1.40 (I2S0_8CH_LRCK_TX->), J12.5, J12.6, J20.5, J20.6, U4.14 (FSYNC), U8.14 (FSYNC)
MCLK: IC1.35 (->I2S0_8CH_MCLK), J12.3, J12.4, J20.3, J20.4, U4.12 (MCLK), U8.12 (MCLK)
Mute: U4.24 (MUTE), U8.24 (MUTE)
unnamed: C13.1, U4.9 (GVDD)
unnamed: C14.1, U4.10 (GVDD)
unnamed: C68.1, U8.9 (GVDD)
unnamed: C69.1, U8.10 (GVDD)
unnamed: HL1.1 (K), R3.1
unnamed: HL2.1 (K), R2.2
unnamed: HL3.1 (K), R20.2
unnamed: HL4.1 (K), R21.1
unnamed: HL5.2 (A), R1.1
unnamed: IC1.23 (GPIO_11/SPI0_SCLK), R6.1, SW1.2
unnamed: C31.2, C39.2, J6.1, L1.2
unnamed: C32.1, C40.1, J6.2, L2.2
unnamed: C33.2, C41.2, J6.3, L3.2
unnamed: C34.1, C42.1, J6.4, L4.2
unnamed: C35.2, C43.2, J6.5, L5.2
unnamed: C36.1, C44.1, J6.6, L6.2
unnamed: C37.2, C45.2, J6.7, L7.2
unnamed: C38.1, C46.1, J6.8, L8.2
unnamed: C85.2, C93.2, J18.1, L9.2
unnamed: C86.1, C94.1, J18.2, L10.2
unnamed: C87.2, C95.2, J18.3, L11.2
unnamed: C88.1, C96.1, J18.4, L12.2
unnamed: C89.2, C97.2, J18.5, L13.2
unnamed: C90.1, C98.1, J18.6, L14.2
unnamed: C91.2, C99.2, J18.7, L15.2
unnamed: C92.1, C100.1, J18.8, L16.2
unnamed: C10.2, C11.2, U4.4 (AREF)
unnamed: C12.1, U4.8 (AVDD)
unnamed: C12.2, U4.7 (AVSS)
unnamed: C29.2, U4.35 (BST+1P)
unnamed: C30.1, U4.31 (BST_1M)
unnamed: C28.1, U4.37 (BST_2M)
unnamed: C27.2, U4.41 (BST_2P)
unnamed: C26.1, U4.44 (BST_3M)
unnamed: C25.2, U4.48 (BST_3P)
unnamed: C24.1, U4.50 (BST_4M)
unnamed: C23.2, U4.54 (BST_4P)
unnamed: R22.1, U4.22 (I2C_ADDR0)
unnamed: C30.2, L8.1, U4.32 (OUT_1M)
unnamed: C29.1, L7.1, U4.34 (OUT_1P)
unnamed: C28.2, L6.1, U4.38 (OUT_2M)
unnamed: C27.1, L5.1, U4.40 (OUT_2P)
unnamed: C26.2, L4.1, U4.45 (OUT_3M)
unnamed: C25.1, L3.1, U4.47 (OUT_3P)
unnamed: C24.2, L2.1, U4.51 (OUT_4M)
unnamed: C23.1, L1.1, U4.53 (OUT_4P)
unnamed: C11.1, U4.6 (VCOM)
unnamed: C10.1, U4.5 (VREG)
unnamed: C65.2, C66.2, U8.4 (AREF)
unnamed: C67.1, U8.8 (AVDD)
unnamed: C67.2, U8.7 (AVSS)
unnamed: C83.2, U8.35 (BST+1P)
unnamed: C84.1, U8.31 (BST_1M)
unnamed: C82.1, U8.37 (BST_2M)
unnamed: C81.2, U8.41 (BST_2P)
unnamed: C80.1, U8.44 (BST_3M)
unnamed: C79.2, U8.48 (BST_3P)
unnamed: C78.1, U8.50 (BST_4M)
unnamed: C77.2, U8.54 (BST_4P)
unnamed: C84.2, L16.1, U8.32 (OUT_1M)
unnamed: C83.1, L15.1, U8.34 (OUT_1P)
unnamed: C82.2, L14.1, U8.38 (OUT_2M)
unnamed: C81.1, L13.1, U8.40 (OUT_2P)
unnamed: C80.2, L12.1, U8.45 (OUT_3M)
unnamed: C79.1, L11.1, U8.47 (OUT_3P)
unnamed: C78.2, L10.1, U8.51 (OUT_4M)
unnamed: C77.1, L9.1, U8.53 (OUT_4P)
unnamed: C66.1, U8.6 (VCOM)
unnamed: C65.1, U8.5 (VREG)
PVDD: C15.2, C17.2, C18.2, C19.2, C20.1, C21.2, C22.1, C47.2, C64.2, C70.2, C71.2, C72.2, C73.2, C74.1, C75.2, C76.1, U4.2 (PVDD), U4.29 (PVDD), U4.30 (PVDD), U4.42 (PVDD), U4.43 (PVDD), U4.55 (PVDD), U4.56 (PVDD), U8.2 (PVDD), U8.29 (PVDD), U8.30 (PVDD), U8.42 (PVDD), U8.43 (PVDD), U8.55 (PVDD), U8.56 (PVDD); also elsewhere on the board
REMOTE: IC1.15 (GPIO_22); also elsewhere on the board
SCL: IC1.5 (GPIO_3/[I2C]_SCL), R4.2, U4.20 (SCL), U8.20 (SCL)
SDA: IC1.3 (GPIO_2/[I2C]_SDA), R5.2, U4.21 (SDA), U8.21 (SDA)
SDATAIN0: IC1.7 (->I2S0_8CH_SDI0), J12.9
SDATAIN1: IC1.11 (->I2S0_8CH_SDI1), J20.9
SDATAOUT0: IC1.12 (I2S0_8CH_SDO0->), U8.16 (SDIN2)
SDATAOUT1: IC1.31 (<-I2S0_8CH_SDO1), U8.15 (SDIN1)
SDATAOUT2: IC1.22 (I2S0_8CH_SDO2->), J20.10, U4.16 (SDIN2)
SDATAOUT3: IC1.32 (I2S0_8CH_SDO3->), J12.10, U4.15 (SDIN1)
Standby: U4.25 (STANDBY), U8.25 (STANDBY)
VBAT: U4.3 (VBAT), U8.3 (VBAT); also elsewhere on the board
WARN0: R20.1, U8.26 (WARN)
WARN1: R2.1, U4.26 (WARN)
Work: IC1.19 (GPIO_10/SPI0_MOSI), R1.2

Notes on the sheet:
SPM5020T-3R3M-LR

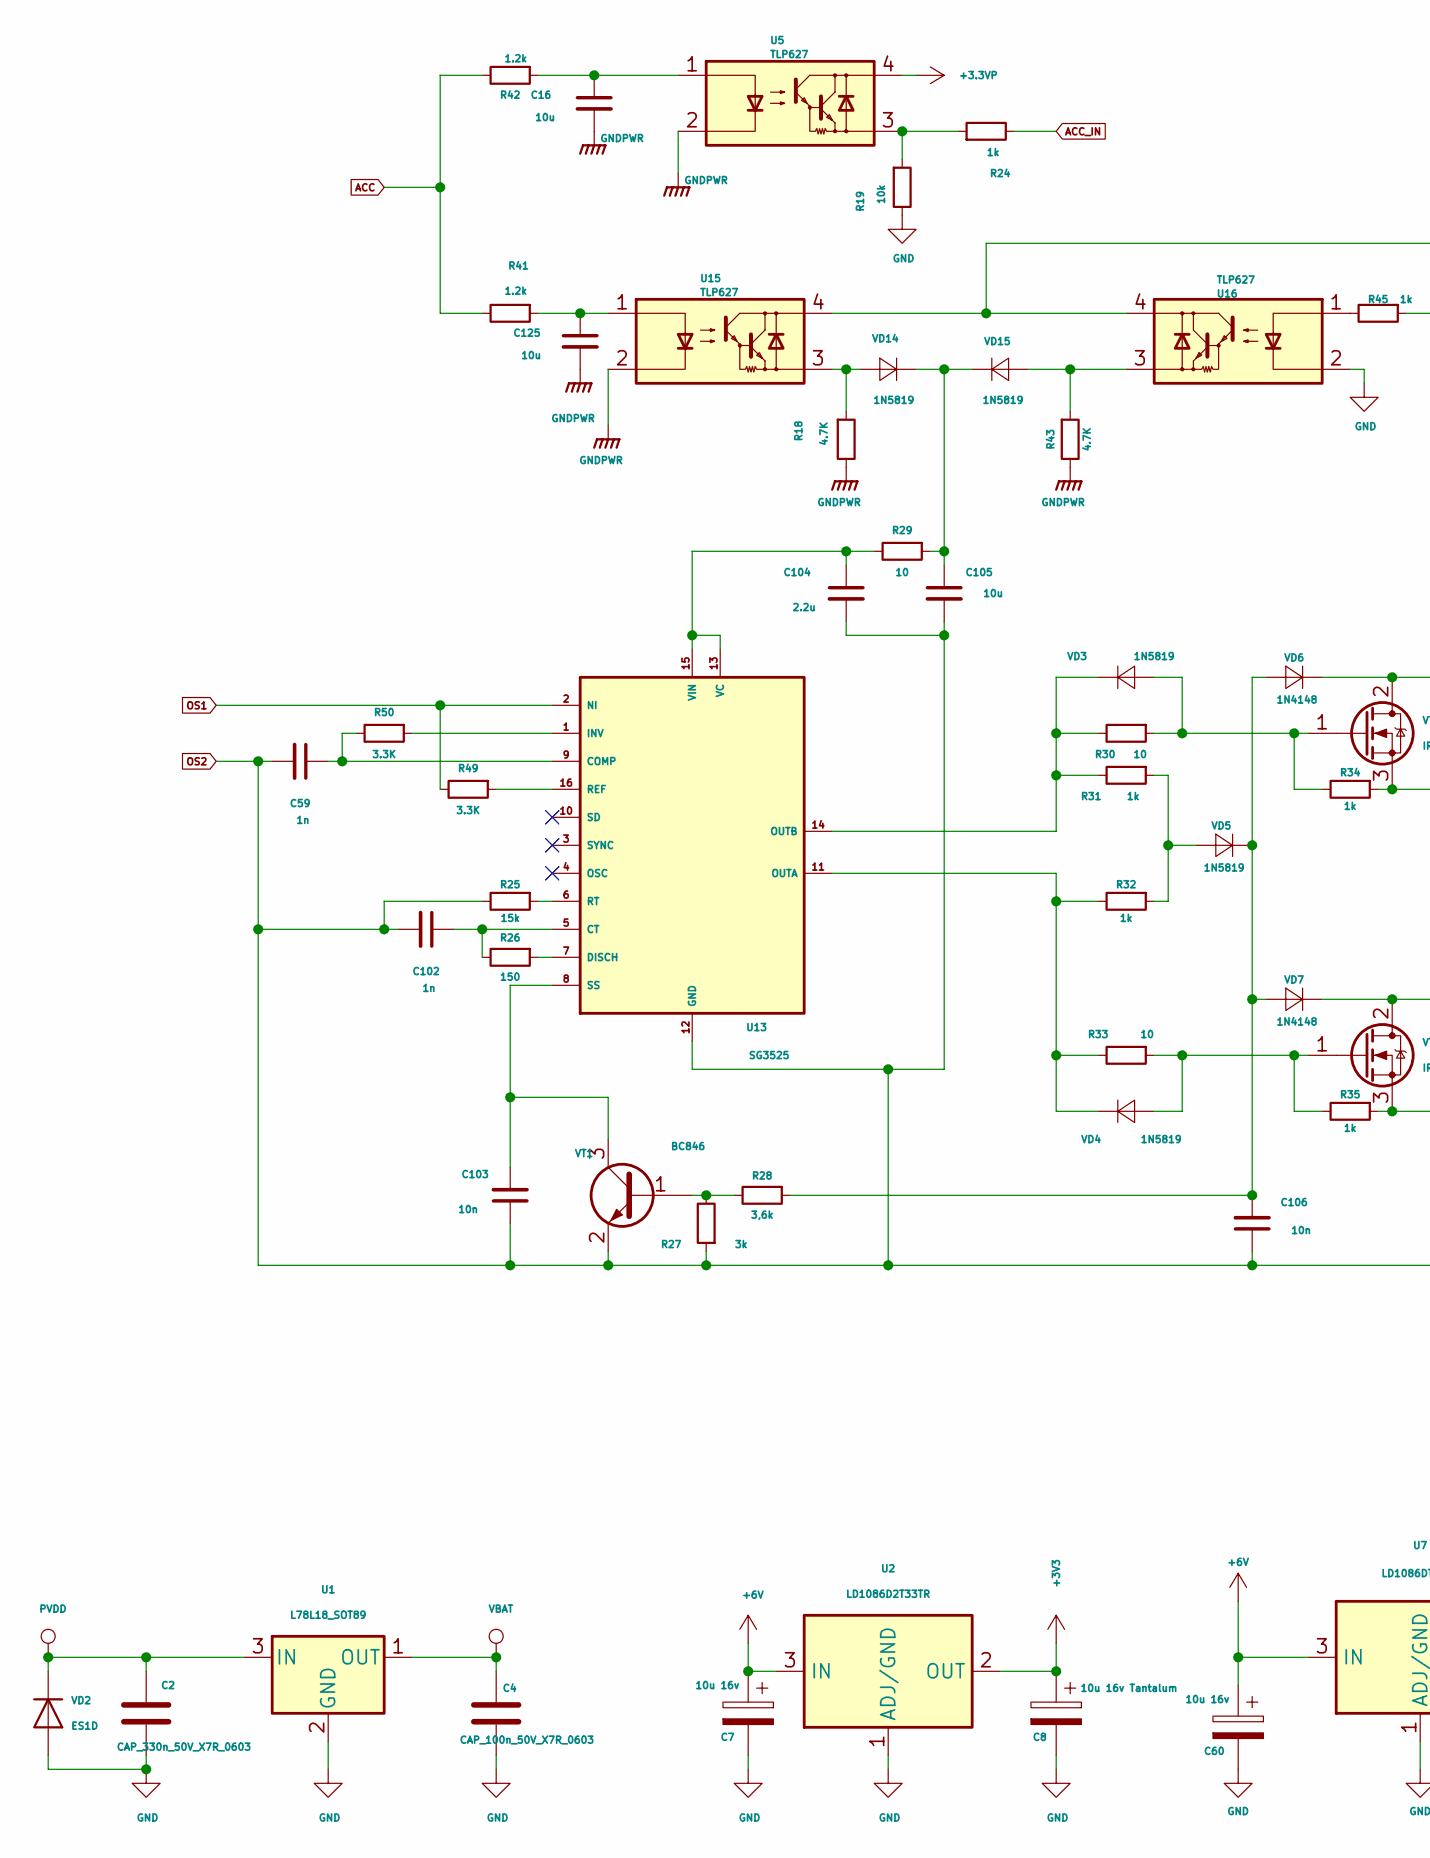
[picture p48: schematic power.kicad_sch, part in row 1, column 1]

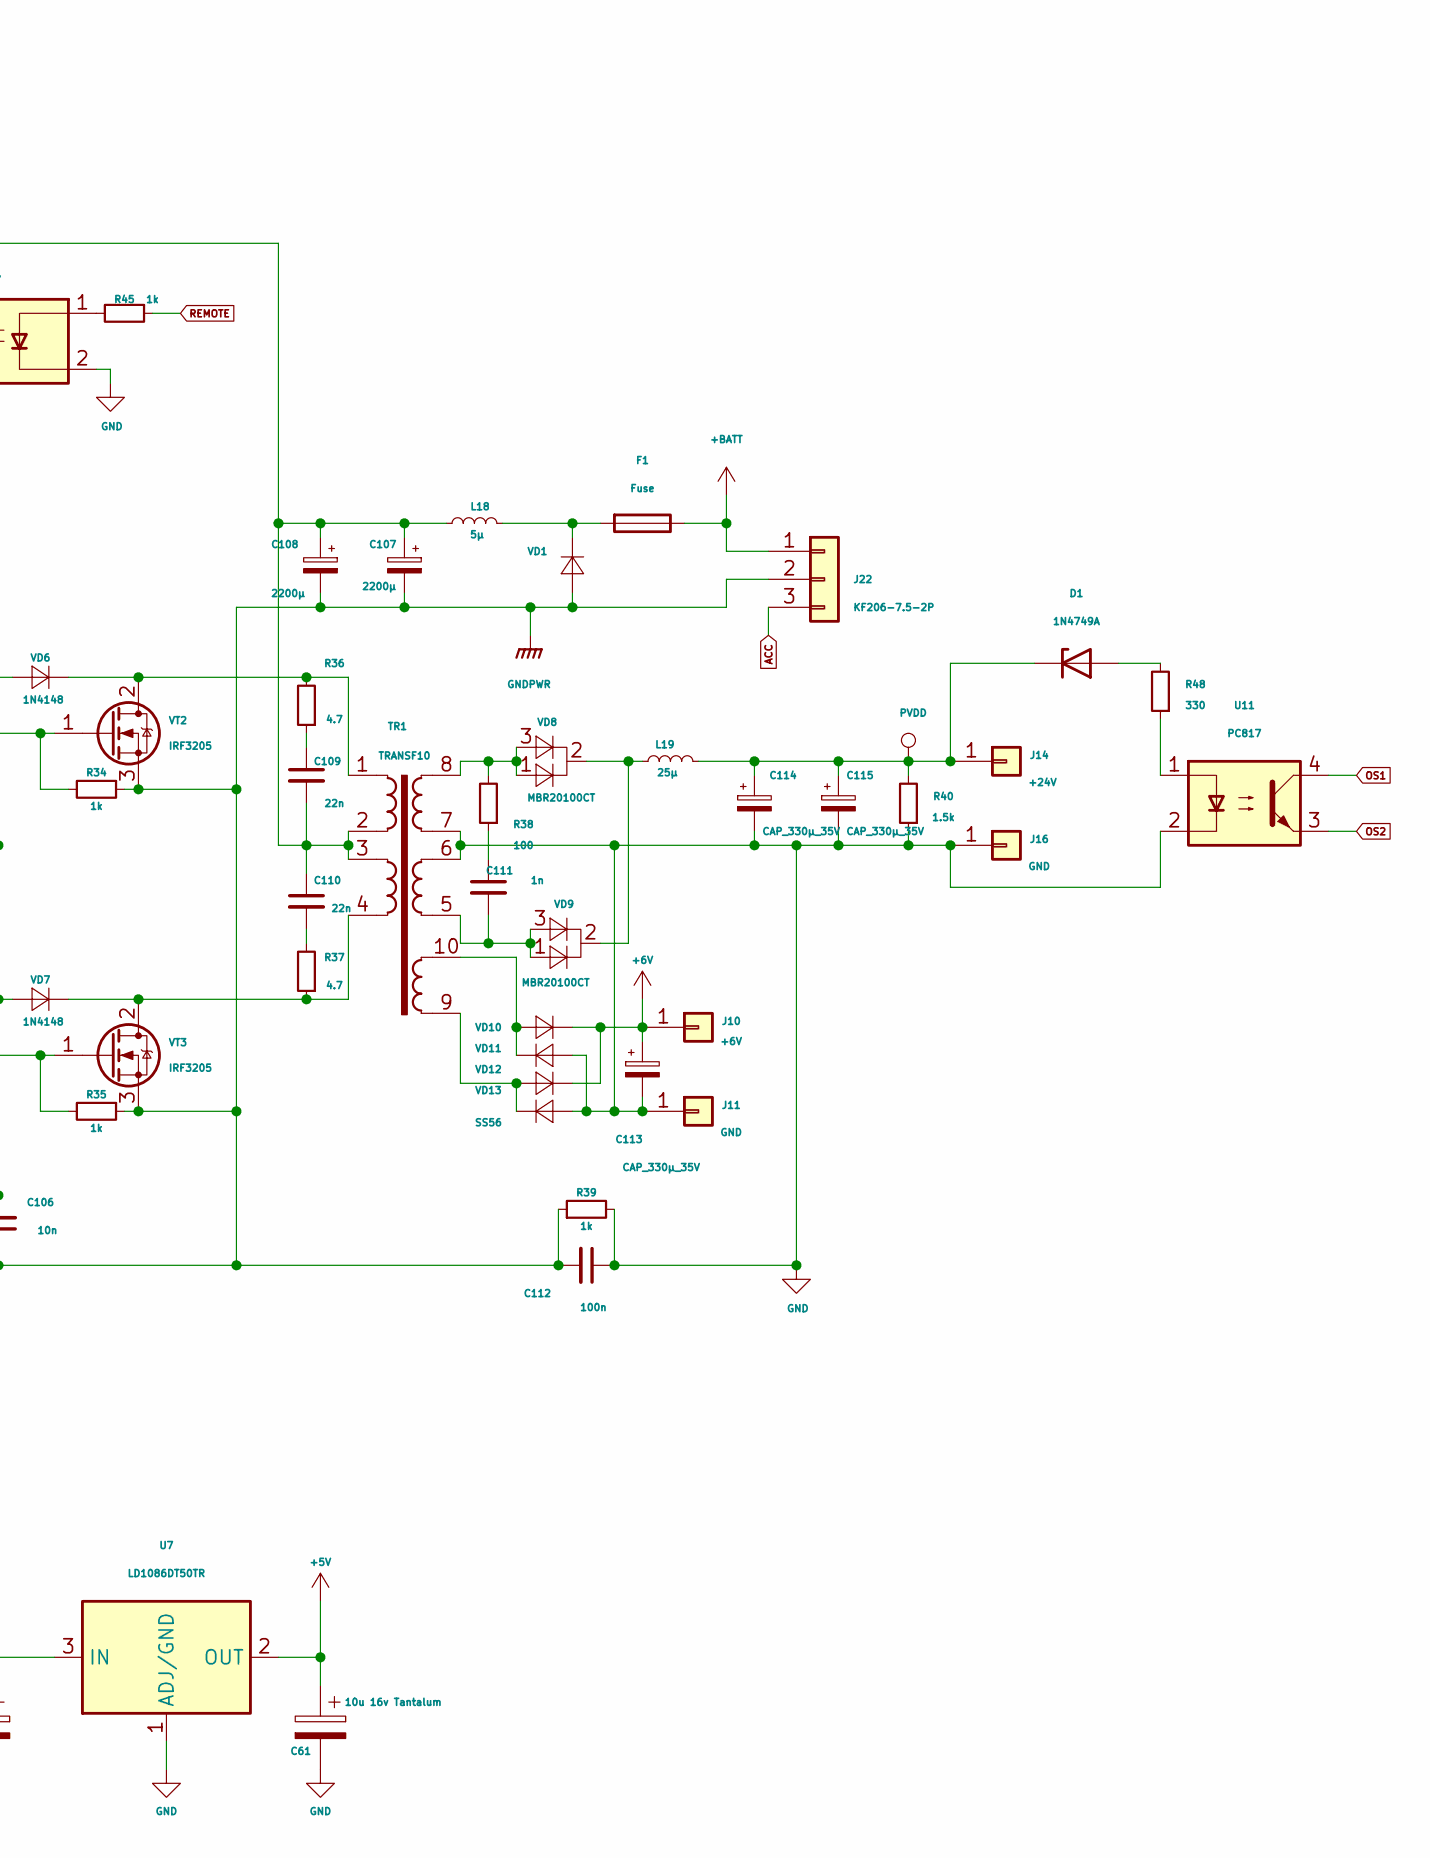
[picture p49: schematic power.kicad_sch, part in row 1, column 2]

Parts:
C2: CAP_330n_50V_X7R_0603; C_0603_1608Metric
C4, C112: CAP_100n_50V_X7R_0603; C_0603_1608Metric
C7, C60: 10u 16v; CP_Elec_8x10
C8, C61: 10u 16v Tantalum; CP_EIA-3216-18_Kemet-A
C16, C105, C125: CAP_10u0_50V_X7R_1206; C_1206_3216Metric
C59, C102, C111: CAP_1n_50V_X7R_0603; C_0603_1608Metric
C103, C106: CAP_10n_50V_X7R_0603; C_0603_1608Metric
C104: CAP_2u2_50V_X7R_1206; C_1206_3216Metric
C107, C108: 2200μ; CP_Radial_D14.0mm_P5.00mm
C109, C110: CAP_22n_50V_X7R_0603; C_0603_1608Metric
C113, C114, C115: CAP_330μ_35V; CP_Radial_D10.0mm_P5.00mm
D1: 1N4749A; D_DO-34_SOD68_P7.62mm_Horizontal
F1: Fuse; Fuse_Blade_vertical
J10: +6V; TestPoint_Pad_1.5x1.5mm
J11, J16: GND; TestPoint_Pad_1.5x1.5mm
J14: +24V; TestPoint_Pad_1.5x1.5mm
J22: KF206-7.5-2P; DG271R-5.0-03P
L18: 5μ; L_Axial_L26.0mm_D9.0mm_P5.08mm_Vertical
L19: 25μ; L_Toroid_Vertical_L33.0mm_W17.8mm_P12.70mm_Pulse_KM-5
R18, R43: 4.7K; R_0603_1608Metric
R19: 10k; R_0603_1608Metric
R24, R31, R32, R34, R35, R39, R45: 1k; R_0603_1608Metric
R25: 15k; R_0603_1608Metric
R26: 150; R_0603_1608Metric
R27: 3k; R_0603_1608Metric
R28: 3,6k; R_0603_1608Metric
R29, R30, R33: 10; R_0603_1608Metric
R36, R37: 4.7; R_Axial_DIN0204_L3.6mm_D1.6mm_P5.08mm_Vertical
R38: 100; R_Axial_DIN0204_L3.6mm_D1.6mm_P5.08mm_Vertical
R40: 1.5k; R_Axial_DIN0204_L3.6mm_D1.6mm_P5.08mm_Vertical
R41, R42: 1.2k; R_1206_3216Metric
R48: 330; R_0603_1608Metric
R49, R50: 3.3K; R_0603_1608Metric
TR1: TRANSF10; Transformer_ETD44_Horizontal
U1: L78L18_SOT89; SOT-89-3
U2: LD1086D2T33TR; TO-263-2
U5, U15, U16: TLP627; DIP-4_W7.62mm
U7: LD1086DT50TR; TO-263-2
U11: PC817; DIP-4_W7.62mm
U13: SG3525; SOIC-16_3.9x9.9mm_P1.27mm
VD1, VD10, VD11, VD12, VD13: SS56; D_SMC
VD2: ES1D; D_SMA
VD3, VD4, VD5, VD14, VD15: 1N5819; D_SMA
VD6, VD7: 1N4148; D_SMA
VD8, VD9: MBR20100CT; TO-220-3_Horizontal_TabUp
VT1: BC846; SOT-23
VT2, VT3: IRF3205; TO-220-3_Horizontal_TabUp

Connections:
+3.3VP: U5.4; also elsewhere on the board
+3V3: C8.1, U2.2 (OUT); also elsewhere on the board
+5V: C61.1, U7.2 (OUT); also elsewhere on the board
+6V: C7.1, C60.1, C113.1, J10.1, U2.3 (IN), U7.3 (IN), VD10.1 (K), VD12.1 (K)
+BATT: F1.1, J22.1
ACC: J22.3, R41.2, R42.2
ACC_IN: R24.2; also elsewhere on the board
GND: C2.2, C4.2, C7.2, C8.2, C60.2, C61.2, C112.1, C113.2, C114.2, C115.2, J11.1, J16.1, R19.2, R39.2, R40.1, TR1.6, TR1.7, U1.2 (GND), U2.1 (ADJ/GND), U7.1 (ADJ/GND), U11.2, U16.2, VD2.2 (A), VD11.2 (A), VD13.2 (A); also elsewhere on the board
unnamed: C16.1, R42.1, U5.1
unnamed: C107.1, C108.1, C109.2, C110.1, L18.2, TR1.2, TR1.3, U15.4, U16.4
unnamed: C109.1, R36.1
unnamed: C110.2, R37.2
unnamed: C111.1, R38.1
unnamed: C125.1, R41.1, U15.1
unnamed: D1.2 (A), R48.2
unnamed: R19.1, R24.1, U5.3
unnamed: R45.2, U16.1
unnamed: R48.1, U11.1
unnamed: C59.1, R50.2, U13.9 (COMP)
unnamed: C102.1, R26.2, U13.5 (CT)
unnamed: R26.1, U13.7 (DISCH)
unnamed: R50.1, U13.1 (INV)
unnamed: R32.2, R33.2, U13.11 (OUTA), VD4.1 (K)
unnamed: R30.2, R31.2, U13.14 (OUTB), VD3.1 (K)
unnamed: R49.1, U13.16 (REF)
unnamed: R25.1, U13.6 (RT)
unnamed: C103.2, U13.8 (SS), VT1.3 (C)
unnamed: C104.1, R29.2, U13.13 (VC), U13.15 (VIN)
unnamed: F1.2, L18.1, VD1.1 (K)
unnamed: R30.1, R34.2, VD3.2 (A), VT2.1 (G)
unnamed: R33.1, R35.2, VD4.2 (A), VT3.1 (G)
unnamed: R31.1, R32.1, VD5.2 (A)
unnamed: C106.2, R28.1, VD5.1 (K), VD6.2 (A), VD7.2 (A)
unnamed: R36.2, TR1.1, VD6.1 (K), VT2.2 (D)
unnamed: R37.1, TR1.4, VD7.1 (K), VT3.2 (D)
unnamed: R38.2, TR1.8, VD8.1 (A1), VD8.3 (A2)
unnamed: L19.1, VD8.2 (A), VD9.2 (A)
unnamed: C111.2, TR1.5, VD9.1 (A1), VD9.3 (A2)
unnamed: TR1.10, VD10.2 (A), VD11.1 (K)
unnamed: TR1.9, VD12.2 (A), VD13.1 (K)
unnamed: R18.1, U15.3, VD14.2 (A)
unnamed: C105.1, R29.1, VD14.1 (K), VD15.1 (K)
unnamed: R43.1, U16.3, VD15.2 (A)
unnamed: R27.2, R28.2, VT1.1 (B)
OS1: R49.2, U11.4, U13.2 (NI)
OS2: C16.2, C59.2, C102.2, C103.1, C104.2, C105.2, C106.1, C107.2, C108.2, C112.2, C125.2, J22.2, R18.2, R25.2, R27.1, R34.1, R35.1, R39.1, R43.2, U5.2, U11.3, U13.12 (GND), U15.2, VD1.2 (A), VT1.2 (E), VT2.3 (S), VT3.3 (S)
PVDD: C2.1, C114.1, C115.1, D1.1 (K), J14.1, L19.2, R40.2, U1.3 (IN), VD2.1 (K); also elsewhere on the board
REMOTE: R45.1; also elsewhere on the board
VBAT: C4.1, U1.1 (OUT); also elsewhere on the board
