mikhalych63/DAW-Pro4/DAW-Pro4/DAW-Pro4.kicad_pcb

## KiCad design DAW-Pro4/DAW-Pro4.kicad_pcb (continued)

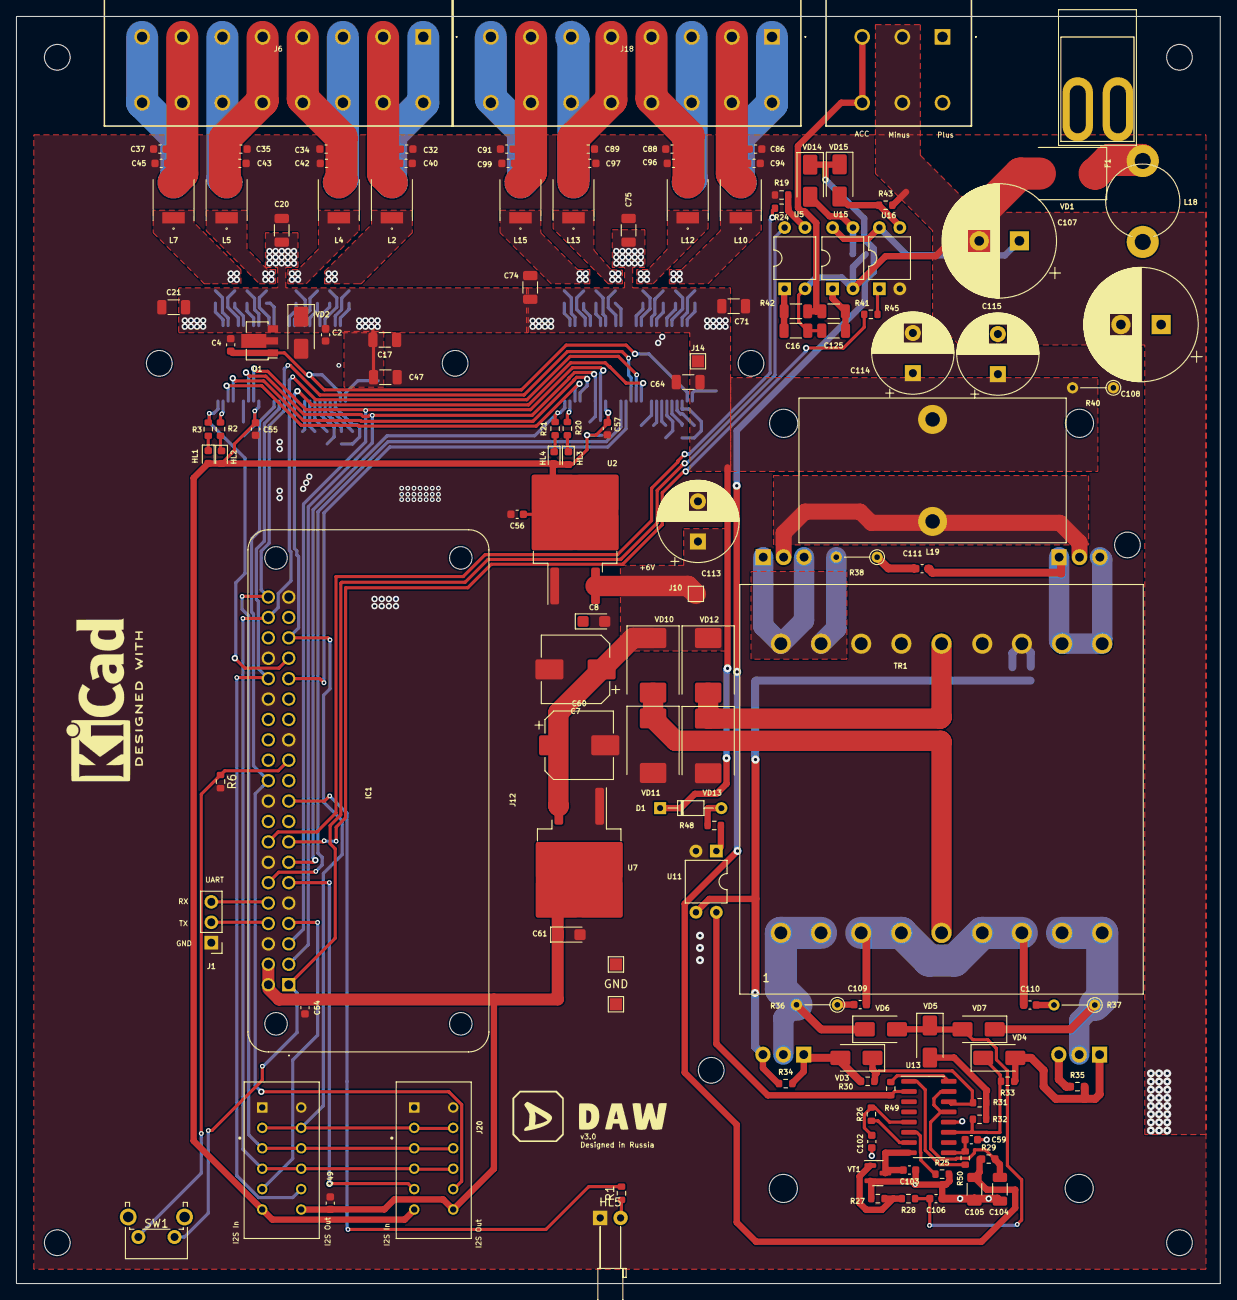
[picture p50: board DAW-Pro4.kicad_pcb from above]

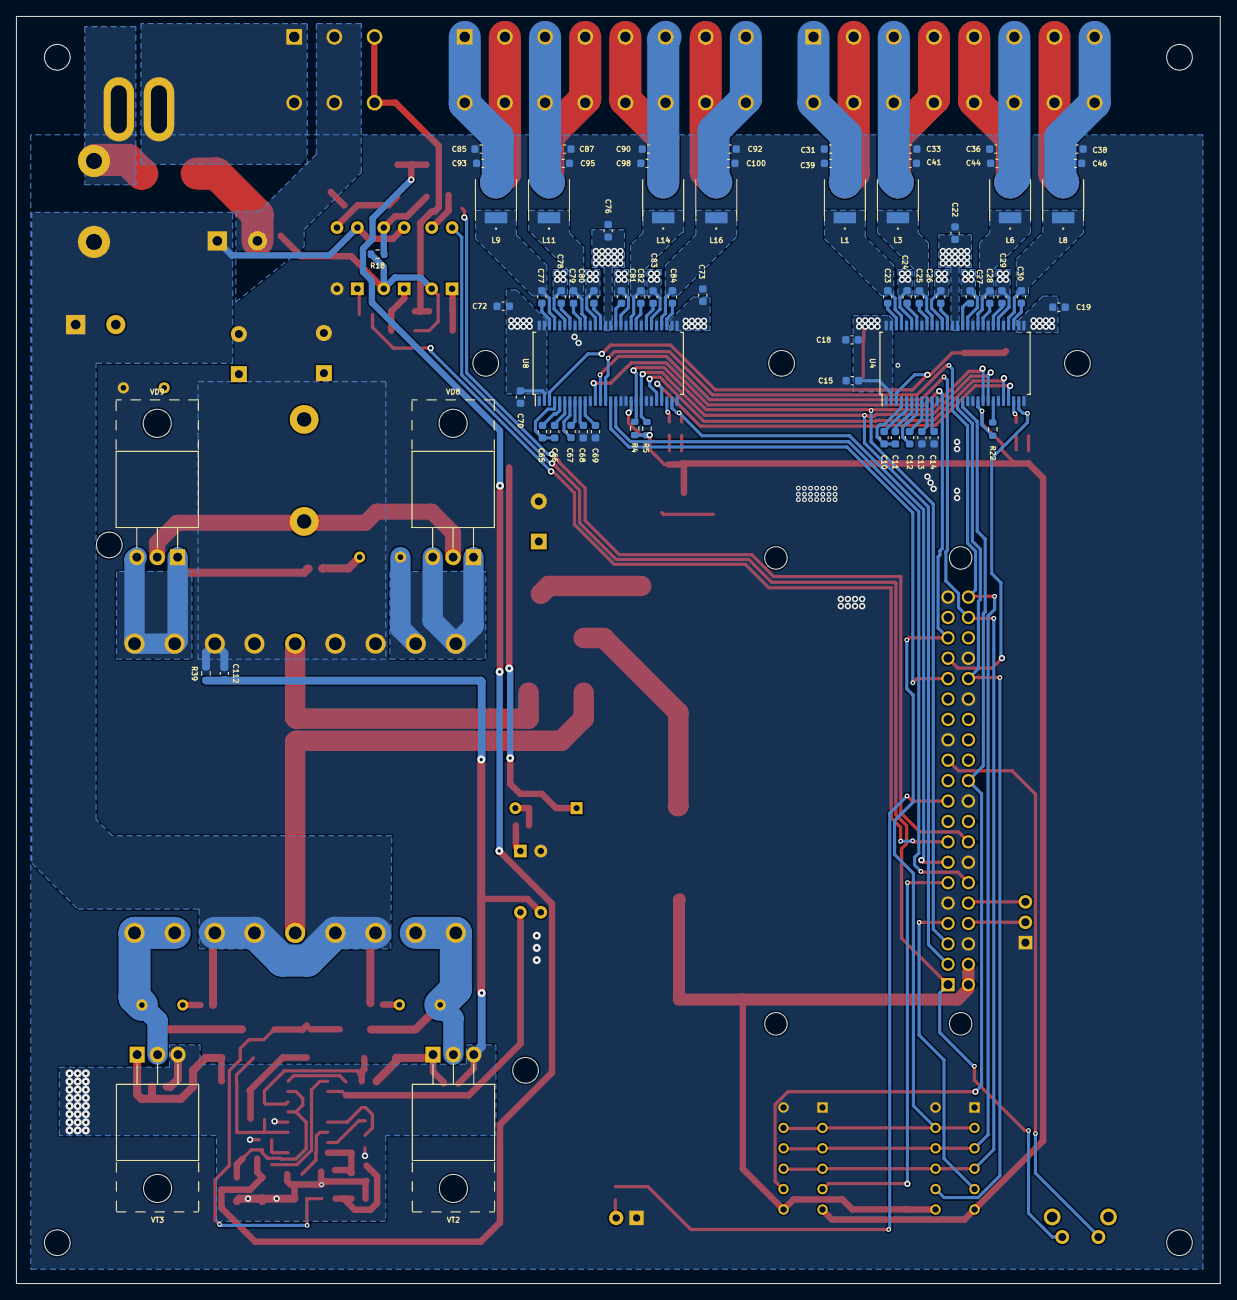
[picture p51: board DAW-Pro4.kicad_pcb from below]

Board: 2 copper layers, 149.9 x 157.7 mm, 203 parts (70 on the bottom side), 138 nets.
