mikhalych63/DAW-Pro4/DAW-Pro4/analog_input/analog_input.kicad_pcb

## KiCad design DAW-Pro4/analog_input/analog_input.kicad_pcb (2024-10-08)

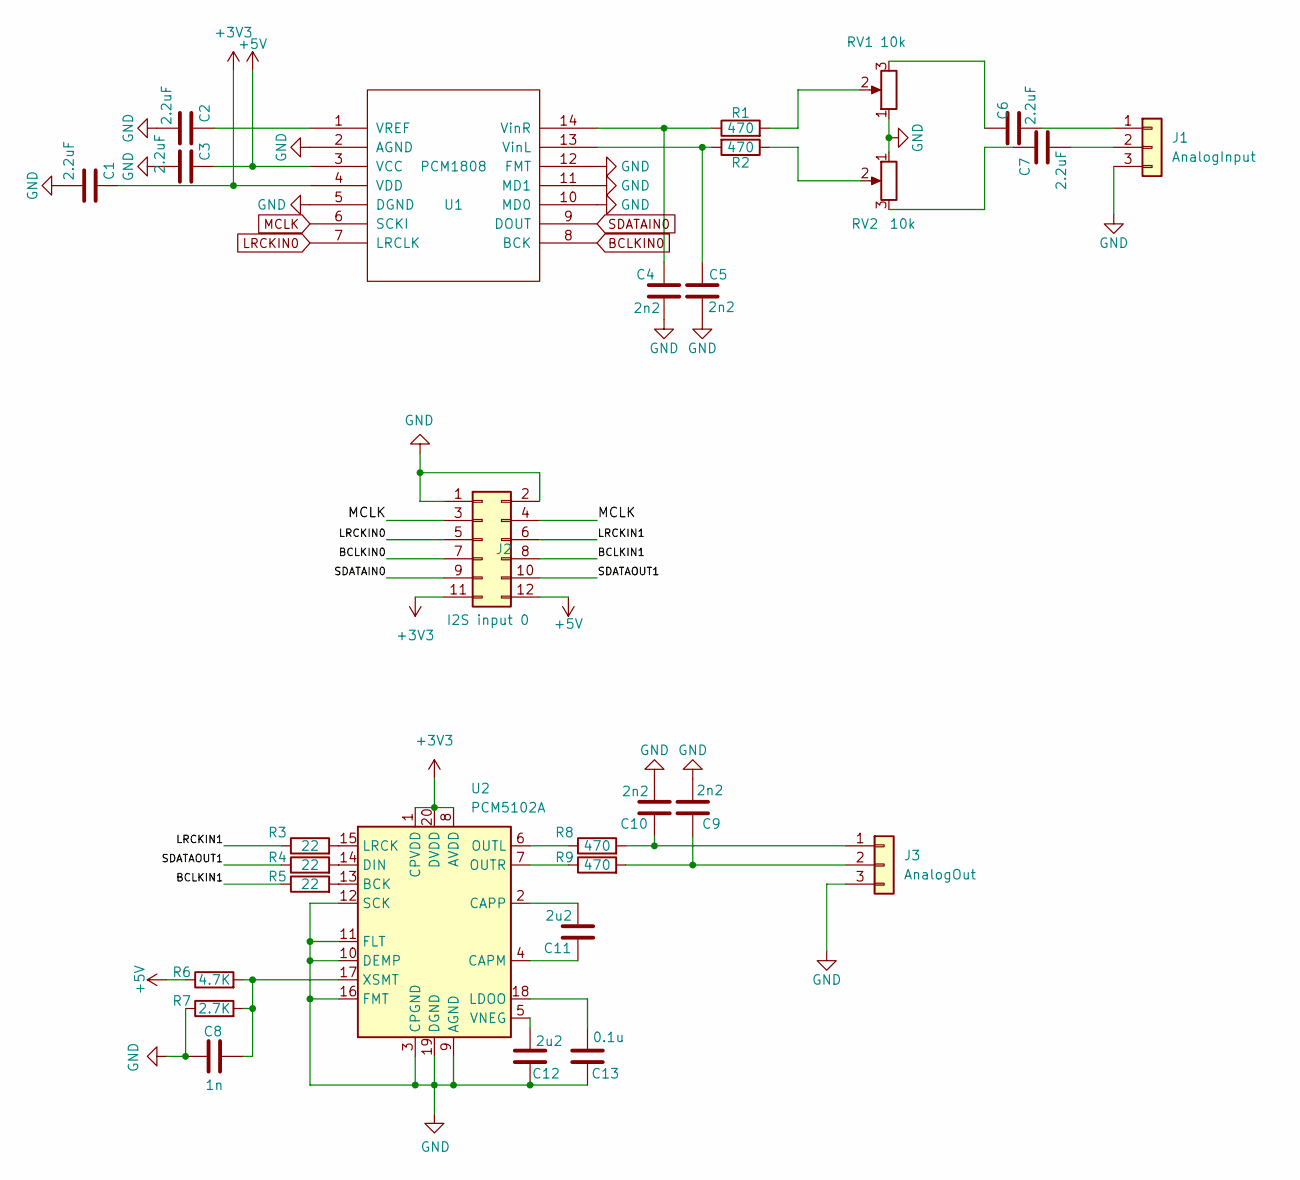
[picture p52: schematic analog_input.kicad_sch]

Parts:
C1, C2, C3, C6, C7: 2.2uF; C_0805_2012Metric
C4, C5, C9, C10: 2n2; C_0603_1608Metric
C8: 1n; C_0603_1608Metric
C11, C12: 2u2; C_0603_1608Metric
C13: 0.1u; C_0603_1608Metric
J1: AnalogInput; JST_XH_B3B-XH-A_1x03_P2.50mm_Vertical
J2: Conn_01x06_Male; EDGE-2x6-2.54
J3: AnalogOut; JST_XH_B3B-XH-A_1x03_P2.50mm_Vertical
R1, R2, R8, R9: 470; R_0603_1608Metric
R3, R4, R5: 22; R_0603_1608Metric
R6: 4.7K; R_0603_1608Metric
R7: 2.7K; R_0603_1608Metric
RV1, RV2: 10k; Potentiometer_Bourns_3314G_Vertical
U1: PCM1808; TSSOP-14_4.4x5mm_P0.65mm
U2: PCM5102A; TSSOP-20_4.4x6.5mm_P0.65mm

Connections:
+3V3: C1.1, J2.11, U1.4 (VDD), U2.1 (CPVDD), U2.8 (AVDD), U2.20 (DVDD)
+5V: C3.1, J2.12, R6.1, U1.3 (VCC)
/BCLKIN1: J2.8, R5.1
/LRCKIN1: J2.6, R3.1
/SDATAOUT1: J2.10, R4.1
BCLKIN0: J2.7, U1.8 (BCK)
GND: C1.2, C2.2, C3.2, C4.1, C5.1, C8.2, C9.1, C10.1, C12.2, C13.2, J1.3, J2.1, J2.2, J3.3, R7.1, RV1.1, RV2.1, U1.2 (AGND), U1.5 (DGND), U1.10 (MD0), U1.11 (MD1), U1.12 (FMT), U2.3 (CPGND), U2.9 (AGND), U2.10 (DEMP), U2.11 (FLT), U2.12 (SCK), U2.16 (FMT), U2.19 (DGND)
LRCKIN0: J2.5, U1.7 (LRCLK)
MCLK: J2.3, J2.4, U1.6 (SCKI)
unnamed: C6.2, RV1.3
unnamed: C7.1, RV2.3
unnamed: C6.1, J1.1
unnamed: C7.2, J1.2
unnamed: C10.2, J3.1, R8.2
unnamed: C9.2, J3.2, R9.2
unnamed: R1.2, RV1.2
unnamed: R2.1, RV2.2
unnamed: C2.1, U1.1 (VREF)
unnamed: C5.2, R2.2, U1.13 (VinL)
unnamed: C4.2, R1.1, U1.14 (VinR)
unnamed: R5.2, U2.13 (BCK)
unnamed: C11.2, U2.4 (CAPM)
unnamed: C11.1, U2.2 (CAPP)
unnamed: R4.2, U2.14 (DIN)
unnamed: C13.1, U2.18 (LDOO)
unnamed: R3.2, U2.15 (LRCK)
unnamed: R8.1, U2.6 (OUTL)
unnamed: R9.1, U2.7 (OUTR)
unnamed: C12.1, U2.5 (VNEG)
unnamed: C8.1, R6.2, R7.2, U2.17 (XSMT)
SDATAIN0: J2.9, U1.9 (DOUT)

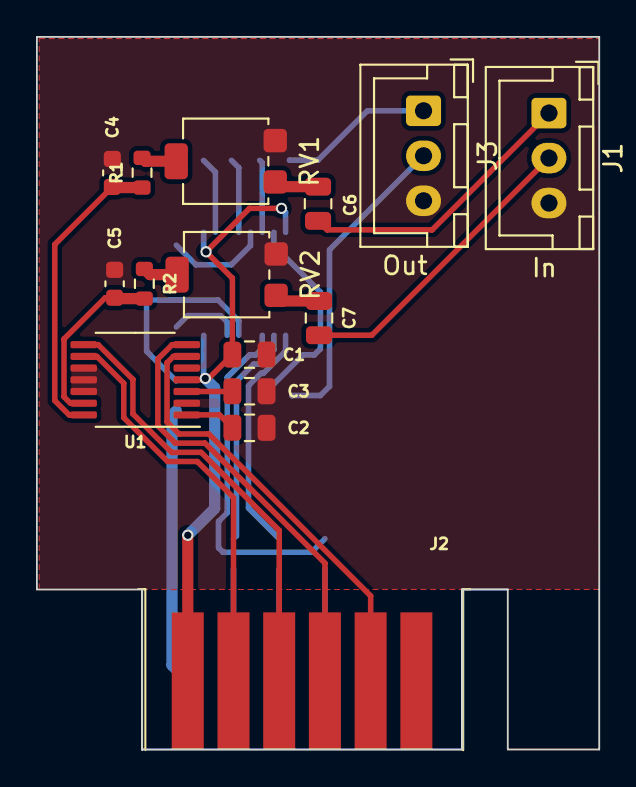
[picture p53: board analog_input.kicad_pcb from above]

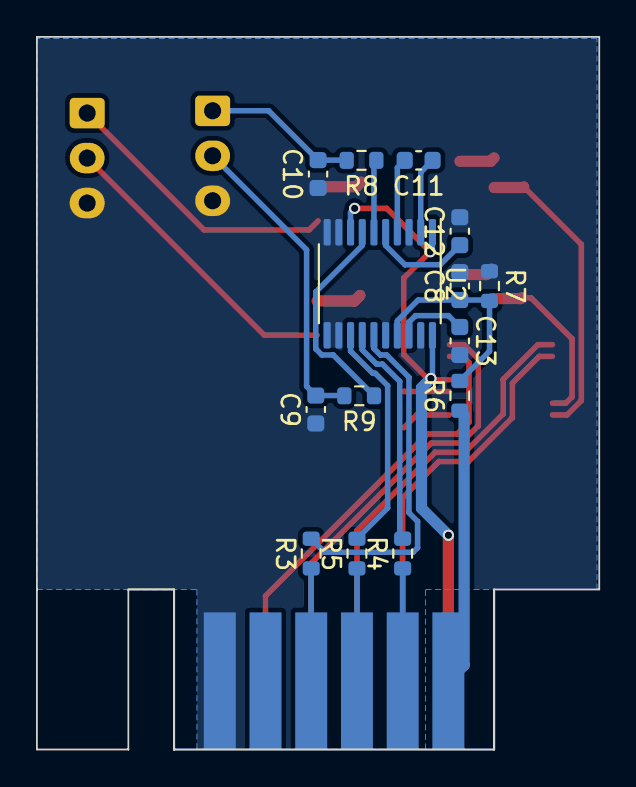
[picture p54: board analog_input.kicad_pcb from below]

Board: 2 copper layers, 31.2 x 39.6 mm, 29 parts (14 on the bottom side), 31 nets.
